cmu-argus-2/Avionics-Mainboard/Avionics-MainBoard.step

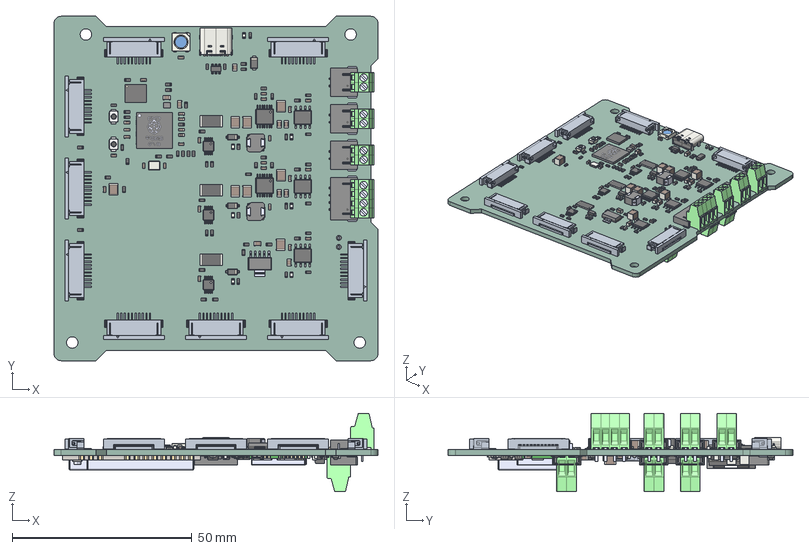
[picture p1: CAD file, 2025-10-24]
Avionics-MainBoard.step
90.2 x 95.9 x 21.8 mm
R_0603_1608Metric x 146
R_2512_6332Metric x 3
C_0603_1608Metric x 53
AOTA-B201610S3R3-101-T
C_0805_2012Metric x 15
SW_SPST_B3U-1000P x 2
MSOP-10_3x3mm_P0.5mm x 3
HSOP-8-1EP_3.9x4.9mm_P1.27mm_EP2.41x3.1mm x 3
DFN-8-1EP_6x5mm_P1.27mm_EP4x4mm
LED_0603_1608Metric x 7
C_1210_3225Metric x 12
Crystal_SMD_3225-4Pin_3.2x2.5mm
RP2350B
LED_WS2812B_PLCC4_5.0x5.0mm_P3.2mm
USB_C_Receptacle_GCT_USB4105-xx-A_16P_TopMnt_Horizontal
D_PowerDI-123
D_SOD-123 x 3
SPM5030T-3R3M-HZ x 2
Fuse_0603_1608Metric x 3
TPS7A4501DCQT
SOT-23-6
HTSSOP-14-1EP_4.4x5mm_P0.65mm_EP3.4x5mm_Mask3x3.1mm x 2
SOT-363_SC-70-6 x 22
D_SMA
SOT-23 x 3
SOIC-8_3.9x4.9mm_P1.27mm
E22-900M30S
DFN-6-1EP_2x2mm_P0.65mm_EP1x1.6mm
SOIC-16W_7.5x10.3mm_P1.27mm
BMX160_BOS
BatteryHolder_LINX_BAT-HLD-012-SMT
TSOT-23-6
SIRA99DP-T1-GE3
U.FL_Hirose_U.FL-R-SMT-1_Vertical
GPS
Avionics-MainBoard_PCB
