cmu-argus-2/Avionics-Mainboard/(threads)

Thread 10 (2025-01-13):

Fix Radio GPIO pinout

NeilKhera, 2025-01-13:
We forgot to route the interrupt pin, whoops

Closed 2025-03-11.

Thread 13 (2025-01-13):

Make RTC resettable

NeilKhera, 2025-01-13:
At the moment the RTC receives contant power from the button cell aka there is no way to power cycle it.

NeilKhera, 2025-06-04:
Likely no fix

Thread 16 (2025-01-13):

Update IC part variants

NeilKhera, 2025-01-13:
Want to be explicit about which variant we are using for certain ICs
Replace BQ25883 to BQ25886 (non I2C)
Replace DS3231S with DS3231SN (Industrial version)
Replace BNO085 with BNO086 (Lower power consumption?)

Closed 2025-03-11.

Thread 18 (2025-01-13):

Mainboard v3 Schematic Completed

NeilKhera, 2025-01-13:
Final Issue checkoff when the schematic is completed

Closed 2025-03-11.

Thread 4 (2025-01-13):

Fix USB charger coil whine

NeilKhera, 2025-01-13:

NeilKhera, 2025-01-13:
TODO: Replace inductor with one that the datasheet recommends

Closed 2025-03-11.

Thread 6 (2025-01-13):

Flaky IMU connections

NeilKhera, 2025-01-13:
Likely a result of bad solder joints. TODO: Update footprint to increase pad size (see, PyCubed-Mini)

NeilKhera, 2025-06-04:
Replace IMU to the BMX160
