cmu-argus-2/Avionics-Mainboard/Avionics-MainBoard.kicad_pcb

## KiCad design Avionics-MainBoard.kicad_pcb (2026-09-04)

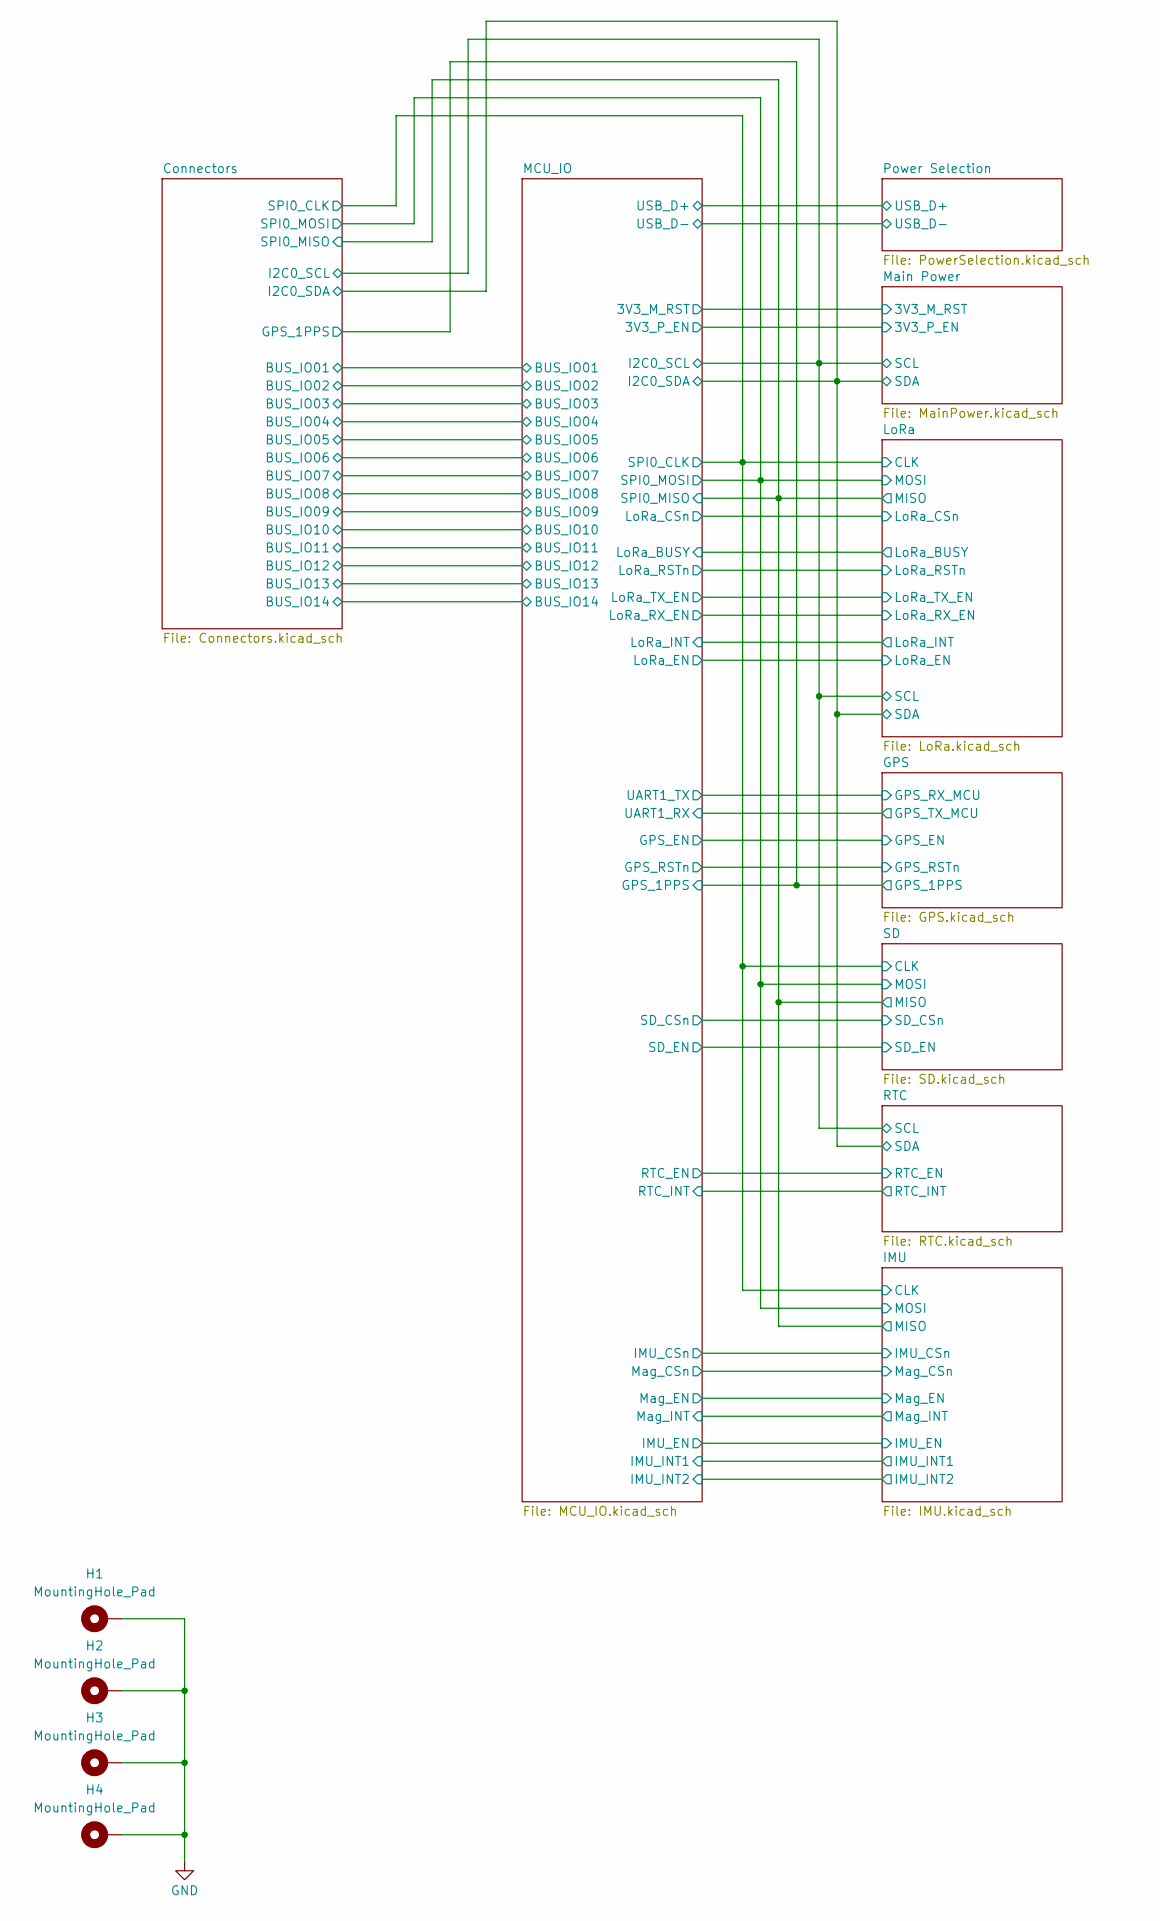
[picture p2: schematic Avionics-MainBoard.kicad_sch, Argus Mainboard]

Parts:
H1, H2, H3, H4: MountingHole_Pad; MountingHole_3.2mm_M3_Pad_Via

Connections:
GND: H1.1 (1_1), H2.1 (1_1), H3.1 (1_1), H4.1 (1_1); also elsewhere on the board

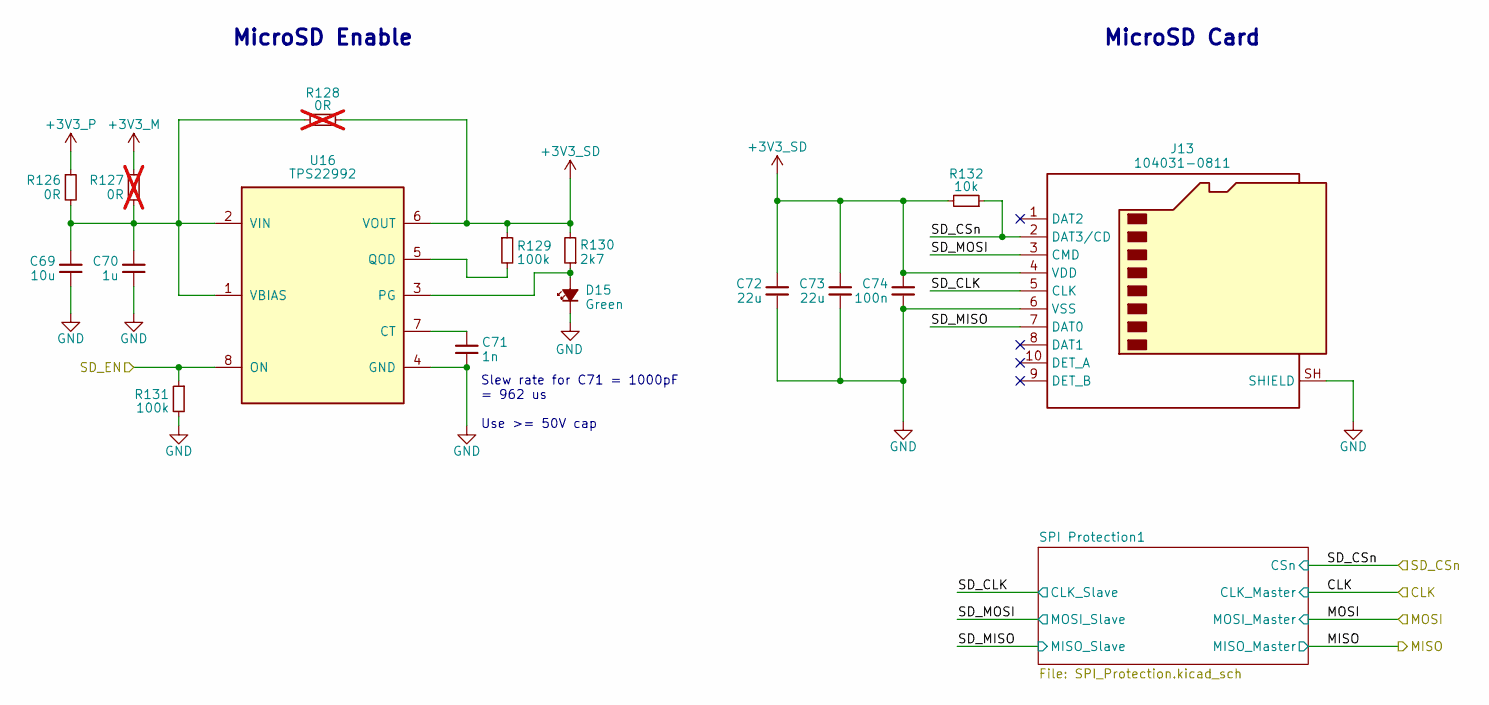
[picture p3: schematic SD.kicad_sch, Argus Mainboard]

Parts:
C69: 10u; C_0805_2012Metric; MPN C307348
C70: 1u; C_0603_1608Metric; MPN C307348
C71: 1n; C_0603_1608Metric; MPN C307348
C72, C73: 22u; C_1210_3225Metric
C74: 100n; C_0603_1608Metric; MPN C307348
D15: LED_G_0603_LTST-C190GKT; LED_0603_1608Metric; MPN C2909774
J13: 104031-0811; microSD_HC_Molex_104031-0811; MPN C585350
R126: 0R; R_0603_1608Metric
R127: 0R; R_0603_1608Metric; not fitted
R128: 0R; R_0603_1608Metric; MPN C2479067; not fitted
R129, R131: 100k; R_0603_1608Metric; MPN C2479067
R130: 2k7; R_0603_1608Metric; MPN C237112
R132: 10k; R_0603_1608Metric; MPN C2479067
U16: TPS22992

Connections:
+3V3_M: R127.1; also elsewhere on the board
+3V3_P: R126.1; also elsewhere on the board
+3V3_SD: C72.1, C73.1, C74.1, J13.4 (VDD), R128.1, R129.1, R130.2, R132.2, U16.6 (VOUT)
/MCU_IO/SD_CSn: J13.2 (DAT3/CD), R132.1; also elsewhere on the board
/MCU_IO/SD_EN: R131.1, U16.8 (ON); also elsewhere on the board
/SD/SD_CLK: J13.5 (CLK); also elsewhere on the board
/SD/SD_MISO: J13.7 (DAT0); also elsewhere on the board
/SD/SD_MOSI: J13.3 (CMD); also elsewhere on the board
GND: C69.2, C70.2, C71.2, C72.2, C73.2, C74.2, D15.1 (K), J13.6 (VSS), J13.SH (SHIELD), R131.2, U16.4 (GND); also elsewhere on the board
unnamed: D15.2 (A), R130.1, U16.3 (PG)
unnamed: C71.1, U16.7 (CT)
unnamed: R129.2, U16.5 (QOD)
unnamed: C69.1, C70.1, R126.2, R127.2, R128.2, U16.1 (VBIAS), U16.2 (VIN)

Notes on the sheet:
Slew rate for C71 = 1000pF = 962 us Use >= 50V cap
MicroSD Enable
MicroSD Card

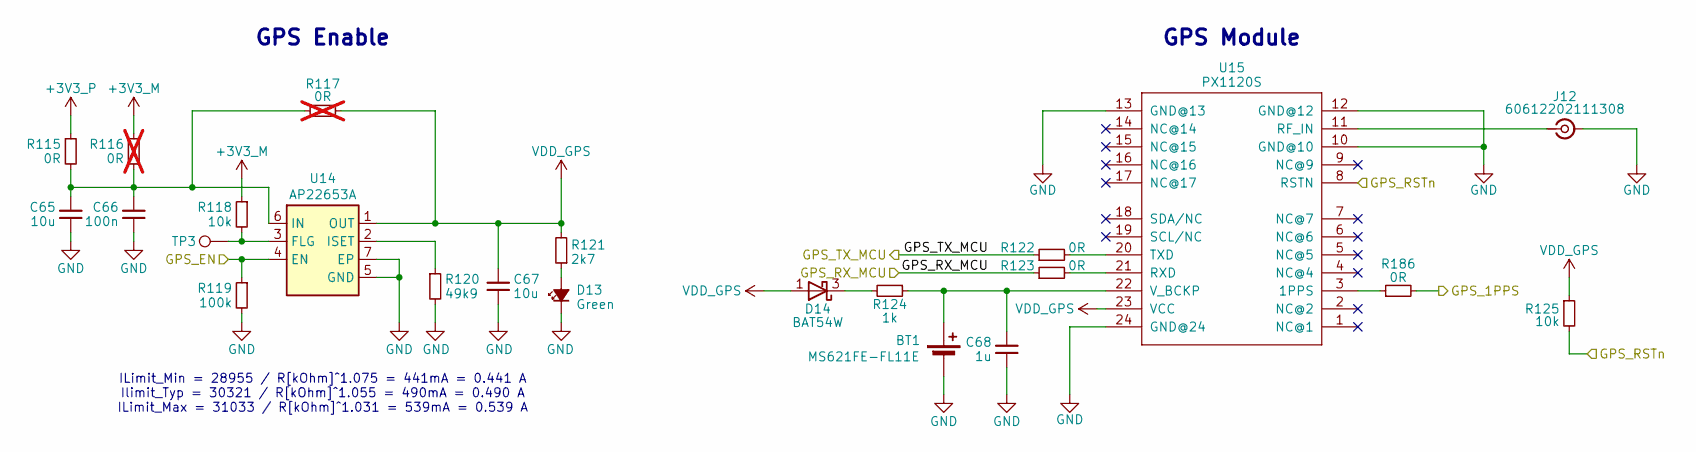
[picture p4: schematic GPS.kicad_sch, Argus Mainboard]

Parts:
BT1: MS621FE-FL11E; BatteryHolder_Seiko_MS621F; MPN MS621FE-FL11E
C65, C67: 10u; C_0805_2012Metric; MPN C386084
C66: 100n; C_0603_1608Metric; MPN C307348
C68: 1u; C_0603_1608Metric; MPN C2214844
D13: LED_G_0603_LTST-C190GKT; LED_0603_1608Metric; MPN C2909774
D14: BAT54W; SOT-323_SC-70
J12: 60612202111308; MPN C88374
R115: 0R; R_0603_1608Metric
R116: 0R; R_0603_1608Metric; not fitted
R117: 0R; R_0603_1608Metric; MPN C2479067; not fitted
R118, R125: 10k; R_0603_1608Metric; MPN C2479067
R119: 100k; R_0603_1608Metric; MPN C237792
R120: 49k9; R_0603_1608Metric; MPN C844789
R121: 2k7; R_0603_1608Metric; MPN C237112
R122, R123, R186: 0R; R_0603_1608Metric; MPN C844915
R124: 1k; R_0603_1608Metric; MPN C2076947
TP3: TestPoint; TestPoint_Pad_D1.5mm
U14: AP22653A; DFN-6-1EP_2x2mm_P0.65mm_EP1x1.6mm; MPN C1511768
U15: PX1120S; S1216_24PIN_PACKAGE

Connections:
+3V3_M: R116.1, R118.1; also elsewhere on the board
+3V3_P: R115.1; also elsewhere on the board
/GPS/GPS_RX_MCU: R123.1; also elsewhere on the board
/GPS/GPS_TX_MCU: R122.1; also elsewhere on the board
/MCU_IO/GPS_1PPS: R186.2; also elsewhere on the board
/MCU_IO/GPS_EN: R119.1, U14.4 (EN); also elsewhere on the board
/MCU_IO/GPS_RSTn: R125.2, U15.8 (RSTN); also elsewhere on the board
GND: BT1.2 (-), C65.1, C66.1, C67.1, C68.1, D13.1 (K), J12.2 (Ext), R119.2, R120.2, U14.5 (GND), U14.7 (EP), U15.10 (GND@10), U15.12 (GND@12), U15.13 (GND@13), U15.24 (GND@24); also elsewhere on the board
unnamed: BT1.1 (+), C68.2, R124.1, U15.22 (V_BCKP)
unnamed: D13.2 (A), R121.1
unnamed: D14.3 (K), R124.2
unnamed: J12.1 (In), U15.11 (RF_IN)
unnamed: R118.2, TP3.1 (1_1), U14.3 (FLG)
unnamed: C65.2, C66.2, R115.2, R116.2, R117.2, U14.6 (IN)
unnamed: R120.1, U14.2 (ISET)
unnamed: R186.1, U15.3 (1PPS)
unnamed: R123.2, U15.21 (RXD)
unnamed: R122.2, U15.20 (TXD)
VDD_GPS: C67.2, D14.1 (A), R117.1, R121.2, R125.1, U14.1 (OUT), U15.23 (VCC)

Notes on the sheet:
ILimit_Min = 28955 / R[kOhm]^1.075 = 441mA = 0.441 A Ilimit_Typ = 30321 / R[kOhm]^1.055 = 490mA = 0.490 A ILimit_Max = 31033 / R[kOhm]^1.031 = 539mA = 0.539 A
GPS Enable
GPS Module

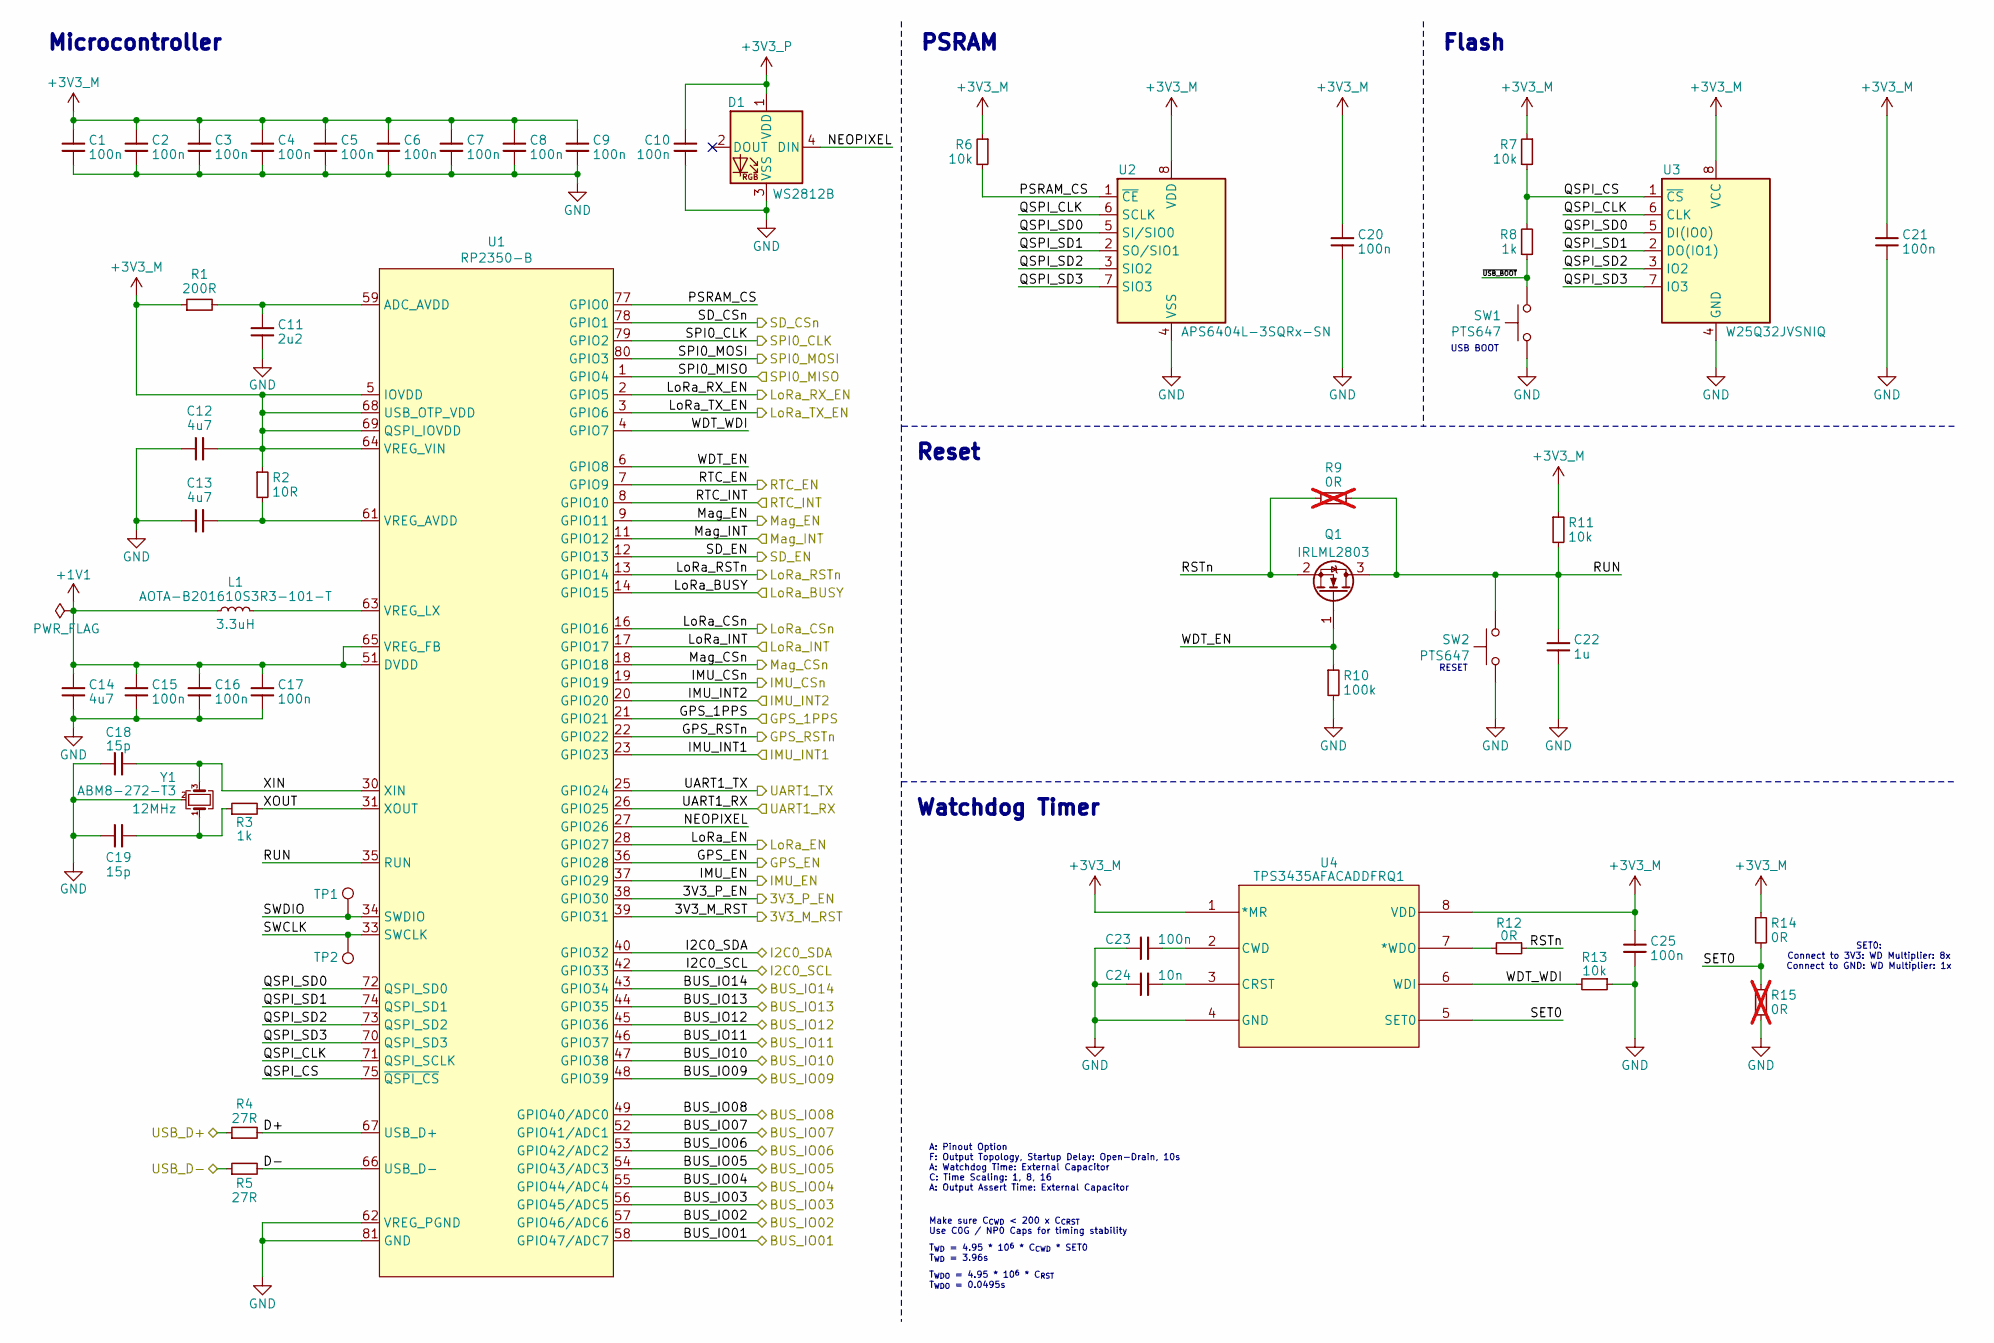
[picture p5: schematic MCU_IO.kicad_sch, Argus Mainboard]

Parts:
C1, C2, C3, C4, C5, C6, C7, C8, C9, C10, C15, C16, C17, C20, C21, C25: 100n; C_0603_1608Metric; MPN C307348
C11: 2u2; C_0603_1608Metric; MPN C16193991
C12, C13: 4u7; C_0805_2012Metric; MPN C3861036
C14: 4u7; C_0805_2012Metric; MPN C386084
C18, C19: 15p; C_0603_1608Metric; MPN C346205
C22: 1u; C_0603_1608Metric; MPN C2214844
C23: 100n; C_1210_3225Metric; MPN C307348
C24: 10n; C_0603_1608Metric; MPN C307348
D1: WS2812B; LED_WS2812B_PLCC4_5.0x5.0mm_P3.2mm; MPN C2890040
L1: AOTA-B201610S3R3-101-T; L_0806_2016Metric; MPN C42411119
Q1: IRLML2803; SOT-23; MPN C2590
R1: 200R; R_0603_1608Metric; MPN C844757
R2: 10R; R_0603_1608Metric; MPN C3029194
R3, R8: 1k; R_0603_1608Metric; MPN C2484712
R4, R5: 27R; R_0603_1608Metric; MPN C844545
R6, R7, R11, R13: 10k; R_0603_1608Metric; MPN C2479067
R9: 0R; R_0603_1608Metric; not fitted
R10: 100k; R_0603_1608Metric; MPN C237792
R12: 0R; R_0603_1608Metric; MPN C2479067
R14: 0R; R_0603_1608Metric; MPN C3029194
R15: 0R; R_0603_1608Metric; MPN C3029194; not fitted
SW1, SW2: PTS647; SW_SPST_PTS647_Sx38; MPN C231329
TP1, TP2: TestPoint; TestPoint_Pad_D1.5mm
U1: RP2350-B; RP2350-QFN-80-1EP_10x10_P0.4mm_EP3.4x3.4mm_ThermalVias; MPN C42415655
U2: APS6404L-3SQRx-SN; SOIC-8_3.9x4.9mm_P1.27mm
U3: W25Q32JVSNIQ; DFN-8-1EP_6x5mm_P1.27mm_EP2x2mm
U4: TPS3435AFACADDFRQ1; TSOT-23-8
Y1: ABM8-272-T3; Crystal_SMD_3225-4Pin_3.2x2.5mm; Part 12MHz

Connections:
+1V1: C14.1, C15.1, C16.1, C17.1, L1.1, U1.10 (DVDD), U1.32 (DVDD), U1.51 (DVDD), U1.65 (VREG_FB)
+3V3_M: C1.1, C2.1, C3.1, C4.1, C5.1, C6.1, C7.1, C8.1, C9.1, C12.2, C20.1, C21.1, C25.1, R1.1, R2.1, R6.1, R7.1, R11.1, R14.1, U1.5 (IOVDD), U1.15 (IOVDD), U1.24 (IOVDD), U1.29 (IOVDD), U1.41 (IOVDD), U1.50 (IOVDD), U1.60 (IOVDD), U1.64 (VREG_VIN), U1.68 (USB_OTP_VDD), U1.69 (QSPI_IOVDD), U1.76 (IOVDD), U2.8 (VDD), U3.8 (VCC), U4.1 (*MR), U4.8 (VDD); also elsewhere on the board
+3V3_P: C10.1, D1.1 (VDD); also elsewhere on the board
/GPS/GPS_RX_MCU: U1.25 (GPIO24); also elsewhere on the board
/GPS/GPS_TX_MCU: U1.26 (GPIO25); also elsewhere on the board
/IMU/CLK: U1.79 (GPIO2); also elsewhere on the board
/IMU/IMU_CSn: U1.19 (GPIO19); also elsewhere on the board
/IMU/IMU_INT1: U1.23 (GPIO23); also elsewhere on the board
/IMU/IMU_INT2: U1.20 (GPIO20); also elsewhere on the board
/IMU/MISO: U1.1 (GPIO4); also elsewhere on the board
/IMU/MOSI: U1.80 (GPIO3); also elsewhere on the board
/IMU/Mag_CSn: U1.18 (GPIO18); also elsewhere on the board
/IMU/Mag_INT: U1.11 (GPIO12); also elsewhere on the board
/LoRa/LoRa_BUSY: U1.14 (GPIO15); also elsewhere on the board
/LoRa/LoRa_CSn: U1.16 (GPIO16); also elsewhere on the board
/LoRa/LoRa_INT: U1.17 (GPIO17); also elsewhere on the board
/LoRa/LoRa_RSTn: U1.13 (GPIO14); also elsewhere on the board
/LoRa/LoRa_RX_EN: U1.2 (GPIO5); also elsewhere on the board
/LoRa/LoRa_TX_EN: U1.3 (GPIO6); also elsewhere on the board
/MCU_IO/3V3_M_RST: U1.39 (GPIO31); also elsewhere on the board
/MCU_IO/3V3_P_EN: U1.38 (GPIO30); also elsewhere on the board
/MCU_IO/BUS_IO01: U1.58 (GPIO47/ADC7); also elsewhere on the board
/MCU_IO/BUS_IO02: U1.57 (GPIO46/ADC6); also elsewhere on the board
/MCU_IO/BUS_IO03: U1.56 (GPIO45/ADC5); also elsewhere on the board
/MCU_IO/BUS_IO04: U1.55 (GPIO44/ADC4); also elsewhere on the board
/MCU_IO/BUS_IO05: U1.54 (GPIO43/ADC3); also elsewhere on the board
/MCU_IO/BUS_IO06: U1.53 (GPIO42/ADC2); also elsewhere on the board
/MCU_IO/BUS_IO07: U1.52 (GPIO41/ADC1); also elsewhere on the board
/MCU_IO/BUS_IO08: U1.49 (GPIO40/ADC0); also elsewhere on the board
/MCU_IO/BUS_IO09: U1.48 (GPIO39); also elsewhere on the board
/MCU_IO/BUS_IO10: U1.47 (GPIO38); also elsewhere on the board
/MCU_IO/BUS_IO11: U1.46 (GPIO37); also elsewhere on the board
/MCU_IO/BUS_IO12: U1.45 (GPIO36); also elsewhere on the board
/MCU_IO/BUS_IO13: U1.44 (GPIO35); also elsewhere on the board
/MCU_IO/BUS_IO14: U1.43 (GPIO34); also elsewhere on the board
/MCU_IO/D+: R4.2, U1.67 (USB_D+)
/MCU_IO/D-: R5.2, U1.66 (USB_D-)
/MCU_IO/GPS_1PPS: U1.21 (GPIO21); also elsewhere on the board
/MCU_IO/GPS_EN: U1.36 (GPIO28); also elsewhere on the board
/MCU_IO/GPS_RSTn: U1.22 (GPIO22); also elsewhere on the board
/MCU_IO/I2C0_SCL: U1.42 (GPIO33); also elsewhere on the board
/MCU_IO/I2C0_SDA: U1.40 (GPIO32); also elsewhere on the board
/MCU_IO/IMU_EN: U1.37 (GPIO29); also elsewhere on the board
/MCU_IO/LoRa_EN: U1.28 (GPIO27); also elsewhere on the board
/MCU_IO/Mag_EN: U1.9 (GPIO11); also elsewhere on the board
/MCU_IO/NEOPIXEL: D1.4 (DIN), U1.27 (GPIO26)
/MCU_IO/PSRAM_CS: R6.2, U1.77 (GPIO0), U2.1 (~CE)
/MCU_IO/QSPI_CLK: U1.71 (QSPI_SCLK), U2.6 (SCLK), U3.6 (CLK)
/MCU_IO/QSPI_CS: R7.2, R8.2, U1.75 (~QSPI_CS), U3.1 (~CS)
/MCU_IO/QSPI_SD0: U1.72 (QSPI_SD0), U2.5 (SI/SIO0), U3.5 (DI(IO0))
/MCU_IO/QSPI_SD1: U1.74 (QSPI_SD1), U2.2 (SO/SIO1), U3.2 (DO(IO1))
/MCU_IO/QSPI_SD2: U1.73 (QSPI_SD2), U2.3 (SIO2), U3.3 (IO2)
/MCU_IO/QSPI_SD3: U1.70 (QSPI_SD3), U2.7 (SIO3), U3.7 (IO3)
/MCU_IO/RSTn: Q1.2 (S), R9.1, R12.1
/MCU_IO/RTC_EN: U1.7 (GPIO9); also elsewhere on the board
/MCU_IO/RTC_INT: U1.8 (GPIO10); also elsewhere on the board
/MCU_IO/RUN: C22.1, Q1.3 (D), R9.2, R11.2, SW2.2, U1.35 (RUN)
/MCU_IO/SD_CSn: U1.78 (GPIO1); also elsewhere on the board
/MCU_IO/SD_EN: U1.12 (GPIO13); also elsewhere on the board
/MCU_IO/SET0: R14.2, R15.1, U4.5 (SET0)
/MCU_IO/SWCLK: TP2.1 (1_1), U1.33 (SWCLK)
/MCU_IO/SWDIO: TP1.1 (1_1), U1.34 (SWDIO)
/MCU_IO/WDT_EN: Q1.1 (G), R10.1, U1.6 (GPIO8)
/MCU_IO/WDT_WDI: R13.2, U1.4 (GPIO7), U4.6 (WDI)
/MCU_IO/XIN: C18.2, U1.30 (XIN), Y1.3
/MCU_IO/XOUT: R3.2, U1.31 (XOUT)
/MCU_IO/~USB_BOOT: R8.1, SW1.2
/Power Selection/USB_D+: R4.1; also elsewhere on the board
/Power Selection/USB_D-: R5.1; also elsewhere on the board
GND: C1.2, C2.2, C3.2, C4.2, C5.2, C6.2, C7.2, C8.2, C9.2, C10.2, C11.1, C12.1, C13.2, C14.2, C15.2, C16.2, C17.2, C18.1, C19.2, C20.2, C21.2, C22.2, C23.2, C24.2, C25.2, D1.3 (VSS), R10.2, R13.1, R15.2, SW1.1, SW2.1, U1.62 (VREG_PGND), U1.81 (GND), U2.4 (VSS), U3.4 (GND), U3.9 (GND), U4.4 (GND), Y1.2 (G), Y1.4 (G); also elsewhere on the board
unnamed: C19.1, R3.1, Y1.1
unnamed: C11.2, R1.2, U1.59 (ADC_AVDD)
unnamed: C13.1, R2.2, U1.61 (VREG_AVDD)
unnamed: L1.2, U1.63 (VREG_LX)
unnamed: R12.2, U4.7 (*WDO)
unnamed: C24.1, U4.3 (CRST)
unnamed: C23.1, U4.2 (CWD)

Notes on the sheet:
USB BOOT
Reset
RESET
SET0: Connect to 3V3: WD Multiplier: 8x Connect to GND: WD Multiplier: 1x
T_{WDO} = 4.95 * 10^{6} * C_{RST} T_{WDO} = 0.0495s
Make sure C_{CWD} < 200 x C_{CRST} Use C0G / NP0 Caps for timing stability
T_{WD} = 4.95 * 10^{6} * C_{CWD} * SET0 T_{WD} = 3.96s
Watchdog Timer
PSRAM
Flash
A: Pinout Option F: Output Topology, Startup Delay: Open-Drain, 10s A: Watchdog Time: External Capacitor C: Time Scaling: 1, 8, 16 A: Output Assert Time: External Capacitor
Microcontroller

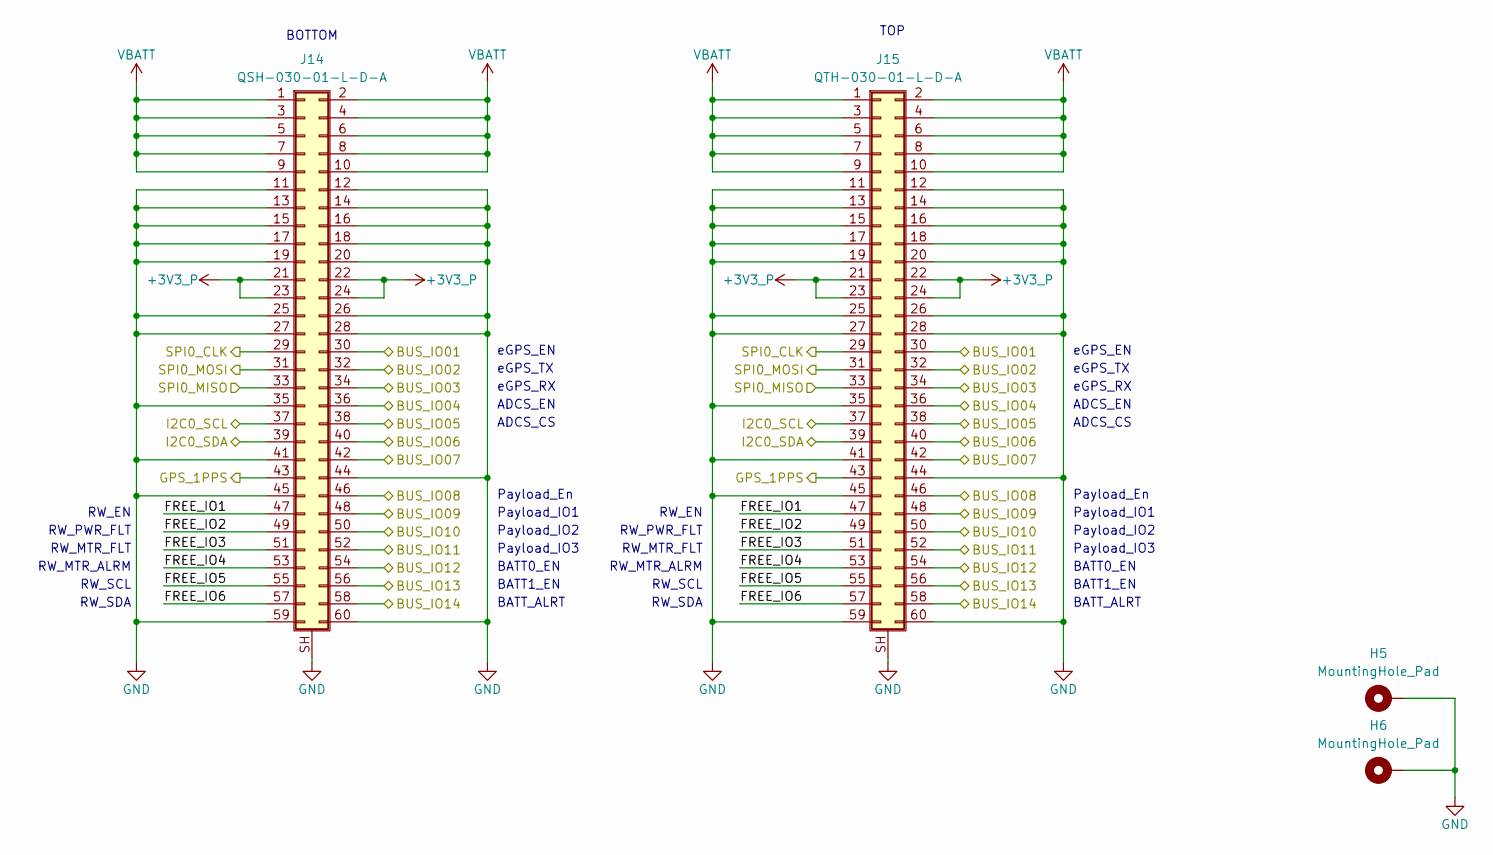
[picture p6: schematic Connectors.kicad_sch, Argus Mainboard]

Parts:
H5, H6: MountingHole_Pad; MountingHole_2.7mm_M2.5_Pad_Via
J14: QSH-030-01-L-D-A; SAMTEC_QSH-030-01-L-D-A
J15: QTH-030-01-L-D-A; SAMTEC-QTH-030-01-X-D-A

Connections:
+3V3_P: J14.21, J14.22, J14.23, J14.24, J15.21, J15.22, J15.23, J15.24; also elsewhere on the board
/Connectors/FREE_IO1: J14.47, J15.47
/Connectors/FREE_IO2: J14.49, J15.49
/Connectors/FREE_IO3: J14.51, J15.51
/Connectors/FREE_IO4: J14.53, J15.53
/Connectors/FREE_IO5: J14.55, J15.55
/Connectors/FREE_IO6: J14.57, J15.57
/IMU/CLK: J14.29, J15.29; also elsewhere on the board
/IMU/MISO: J14.33, J15.33; also elsewhere on the board
/IMU/MOSI: J14.31, J15.31; also elsewhere on the board
/MCU_IO/BUS_IO01: J14.30, J15.30; also elsewhere on the board
/MCU_IO/BUS_IO02: J14.32, J15.32; also elsewhere on the board
/MCU_IO/BUS_IO03: J14.34, J15.34; also elsewhere on the board
/MCU_IO/BUS_IO04: J14.36, J15.36; also elsewhere on the board
/MCU_IO/BUS_IO05: J14.38, J15.38; also elsewhere on the board
/MCU_IO/BUS_IO06: J14.40, J15.40; also elsewhere on the board
/MCU_IO/BUS_IO07: J14.42, J15.42; also elsewhere on the board
/MCU_IO/BUS_IO08: J14.46, J15.46; also elsewhere on the board
/MCU_IO/BUS_IO09: J14.48, J15.48; also elsewhere on the board
/MCU_IO/BUS_IO10: J14.50, J15.50; also elsewhere on the board
/MCU_IO/BUS_IO11: J14.52, J15.52; also elsewhere on the board
/MCU_IO/BUS_IO12: J14.54, J15.54; also elsewhere on the board
/MCU_IO/BUS_IO13: J14.56, J15.56; also elsewhere on the board
/MCU_IO/BUS_IO14: J14.58, J15.58; also elsewhere on the board
/MCU_IO/GPS_1PPS: J14.43, J15.43; also elsewhere on the board
/MCU_IO/I2C0_SCL: J14.37, J15.37; also elsewhere on the board
/MCU_IO/I2C0_SDA: J14.39, J15.39; also elsewhere on the board
GND: H5.1 (1_1), H6.1 (1_1), J14.11, J14.12, J14.13, J14.14, J14.15, J14.16, J14.17, J14.18, J14.19, J14.20, J14.25, J14.26, J14.27, J14.28, J14.35, J14.41, J14.44, J14.45, J14.59, J14.60, J14.SH (Shield), J15.11, J15.12, J15.13, J15.14, J15.15, J15.16, J15.17, J15.18, J15.19, J15.20, J15.25, J15.26, J15.27, J15.28, J15.35, J15.41, J15.44, J15.45, J15.59, J15.60, J15.SH (Shield); also elsewhere on the board
VBATT: J14.1, J14.2, J14.3, J14.4, J14.5, J14.6, J14.7, J14.8, J14.9, J14.10, J15.1, J15.2, J15.3, J15.4, J15.5, J15.6, J15.7, J15.8, J15.9, J15.10; also elsewhere on the board

Notes on the sheet:
BATT1_EN
RW_SCL
RW_PWR_FLT
Payload_IO1
Payload_En
RW_EN
eGPS_TX
eGPS_EN
eGPS_RX
BATT_ALRT
RW_MTR_FLT
ADCS_CS
RW_MTR_ALRM
Payload_IO3
BOTTOM
BATT0_EN
RW_SDA
ADCS_EN
Payload_IO2
TOP

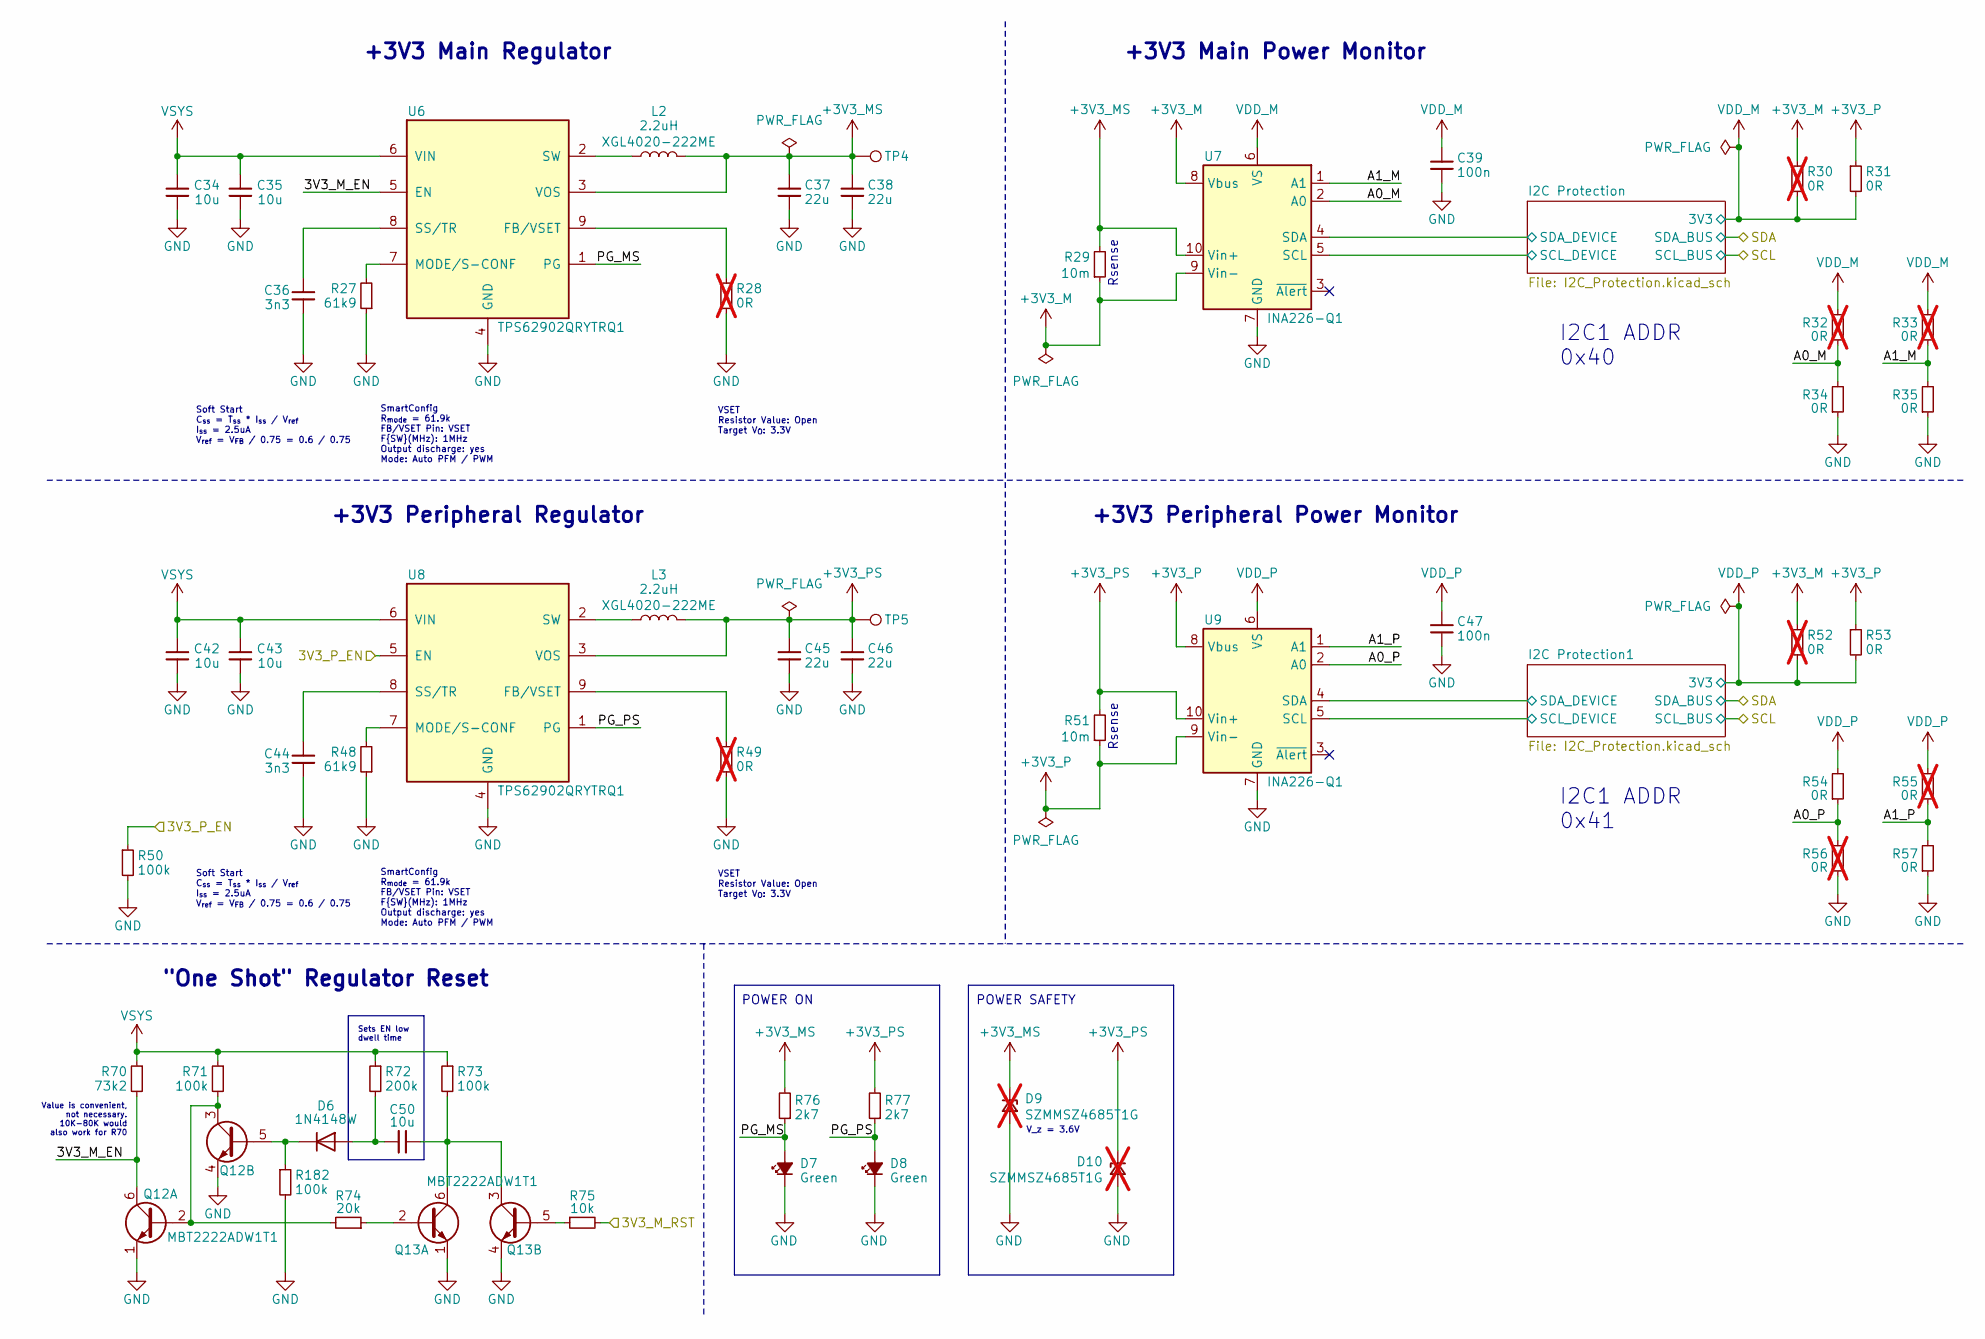
[picture p7: schematic MainPower.kicad_sch, Argus Mainboard]

Parts:
C34, C35, C42, C43, C50: 10u; C_0805_2012Metric; MPN C386084
C36, C44: 3n3; C_0603_1608Metric; MPN C3877267
C37, C38, C45, C46: 22u; C_1210_3225Metric; MPN C2803395
C39, C47: 100n; C_0603_1608Metric; MPN C2803395
D6: 1N4148W; D_SOD-123
D7, D8: LED_G_0603_LTST-C190GKT; LED_0603_1608Metric; MPN C2909774
D9, D10: SZMMSZ4685T1G; D_SOD-123; not fitted
L2, L3: 2.2uH; L_Coilcraft_XAL4020-XXX
Q12: MBT2222ADW1T1; SOT-363_SC-70-6
Q13: MBT2222ADW1T1; SOT-363_SC-70-6; Manufacturer_Part_Number MBT2222ADW1T1G
R27, R48: 61k9; R_0603_1608Metric; MPN C844759
R28, R49: 0R; R_0603_1608Metric; MPN C844759; not fitted
R29, R51: 10m; R_1206_3216Metric; MPN C840621
R30, R52: 0R; R_0603_1608Metric; MPN C237792; not fitted
R31, R53: 0R; R_0603_1608Metric; MPN C237792
R32, R33, R55, R56: 0R; R_0603_1608Metric; MPN C844915; not fitted
R34, R35, R54, R57: 0R; R_0603_1608Metric; MPN C844915
R50, R71, R73, R182: 100k; R_0603_1608Metric; MPN C237792
R70: 73k2; R_0603_1608Metric; MPN C843966
R72: 200k; R_0603_1608Metric; MPN C118142
R74: 20k; R_0603_1608Metric; MPN C844923
R75: 10k; R_0603_1608Metric; MPN C2479067
R76, R77: 2k7; R_0603_1608Metric; MPN C237112
TP4, TP5: TestPoint; TestPoint_Pad_D1.5mm
U6, U8: TPS62902QRYTRQ1
U7, U9: INA226-Q1; TSSOP-10_3x3mm_P0.5mm

Connections:
+3V3_M: R29.1, R30.1, R52.1, U7.8 (Vbus), U7.9 (Vin-); also elsewhere on the board
+3V3_MS: C37.2, C38.2, D9.1 (K), L2.2, R29.2, R76.2, TP4.1 (1_1), U6.3 (VOS), U7.10 (Vin+)
+3V3_P: R31.1, R51.1, R53.1, U9.8 (Vbus), U9.9 (Vin-); also elsewhere on the board
+3V3_PS: C45.2, C46.2, D10.1 (K), L3.2, R51.2, R77.2, TP5.1 (1_1), U8.3 (VOS), U9.10 (Vin+)
/MCU_IO/3V3_M_RST: R75.2; also elsewhere on the board
/MCU_IO/3V3_P_EN: R50.1, U8.5 (EN); also elsewhere on the board
/Main Power/3V3_M_EN: Q12.6 (C1), R70.2, U6.5 (EN)
/Main Power/A0_M: R32.1, R34.2, U7.2 (A0)
/Main Power/A0_P: R54.1, R56.2, U9.2 (A0)
/Main Power/A1_M: R33.1, R35.2, U7.1 (A1)
/Main Power/A1_P: R55.1, R57.2, U9.1 (A1)
/Main Power/I2C Protection1/SCL_DEVICE: U9.5 (SCL); also elsewhere on the board
/Main Power/I2C Protection1/SDA_DEVICE: U9.4 (SDA); also elsewhere on the board
/Main Power/I2C Protection/SCL_DEVICE: U7.5 (SCL); also elsewhere on the board
/Main Power/I2C Protection/SDA_DEVICE: U7.4 (SDA); also elsewhere on the board
/Main Power/PG_MS: D7.2 (A), R76.1, U6.1 (PG)
/Main Power/PG_PS: D8.2 (A), R77.1, U8.1 (PG)
GND: C34.2, C35.2, C36.1, C37.1, C38.1, C39.1, C42.2, C43.2, C44.1, C45.1, C46.1, C47.1, D7.1 (K), D8.1 (K), D9.2 (A), D10.2 (A), Q12.1 (E1), Q12.4 (E2), Q13.1 (E1), Q13.4 (E2), R27.1, R28.1, R34.1, R35.1, R48.1, R49.1, R50.2, R56.1, R57.1, R182.2, U6.4 (GND), U7.7 (GND), U8.4 (GND), U9.7 (GND); also elsewhere on the board
unnamed: C50.2, D6.2 (A), R72.2
unnamed: D6.1 (K), Q12.5 (B2), R182.1
unnamed: Q12.2 (B1), Q12.3 (C2), R71.2, R74.2
unnamed: Q13.2 (B1), R74.1
unnamed: C50.1, Q13.3 (C2), Q13.6 (C1), R73.2
unnamed: Q13.5 (B2), R75.1
unnamed: R28.2, U6.9 (FB/VSET)
unnamed: R27.2, U6.7 (MODE/S-CONF)
unnamed: C36.2, U6.8 (SS/TR)
unnamed: L2.1, U6.2 (SW)
unnamed: R49.2, U8.9 (FB/VSET)
unnamed: R48.2, U8.7 (MODE/S-CONF)
unnamed: C44.2, U8.8 (SS/TR)
unnamed: L3.1, U8.2 (SW)
VDD_M: C39.2, R30.2, R31.2, R32.2, R33.2, U7.6 (VS); also elsewhere on the board
VDD_P: C47.2, R52.2, R53.2, R54.2, R55.2, U9.6 (VS); also elsewhere on the board
VSYS: C34.1, C35.1, C42.1, C43.1, R70.1, R71.1, R72.1, R73.1, U6.6 (VIN), U8.6 (VIN); also elsewhere on the board

Notes on the sheet:
Rsense
VSET Resistor Value: Open Target V_{O}: 3.3V
Sets EN low dwell time
V_z = 3.6V
I2C1 ADDR 0x41
SmartConfig R_{mode} = 61.9k FB/VSET Pin: VSET F{SW}(MHz): 1MHz Output discharge: yes Mode: Auto PFM / PWM
Value is convenient, not necessary. 10K-80K would also work for R70
Soft Start C_{ss} = T_{ss} * I_{ss} / V_{ref} I_{ss} = 2.5uA V_{ref} = V_{FB} / 0.75 = 0.6 / 0.75
+3V3 Main Regulator
"One Shot" Regulator Reset
+3V3 Peripheral Power Monitor
I2C1 ADDR 0x40
+3V3 Peripheral Regulator
POWER SAFETY
+3V3 Main Power Monitor
POWER ON
