cmu-argus-2/Avionics-Mainboard/Avionics-MainBoard.kicad_pcb

## KiCad design Avionics-MainBoard.kicad_pcb (continued)

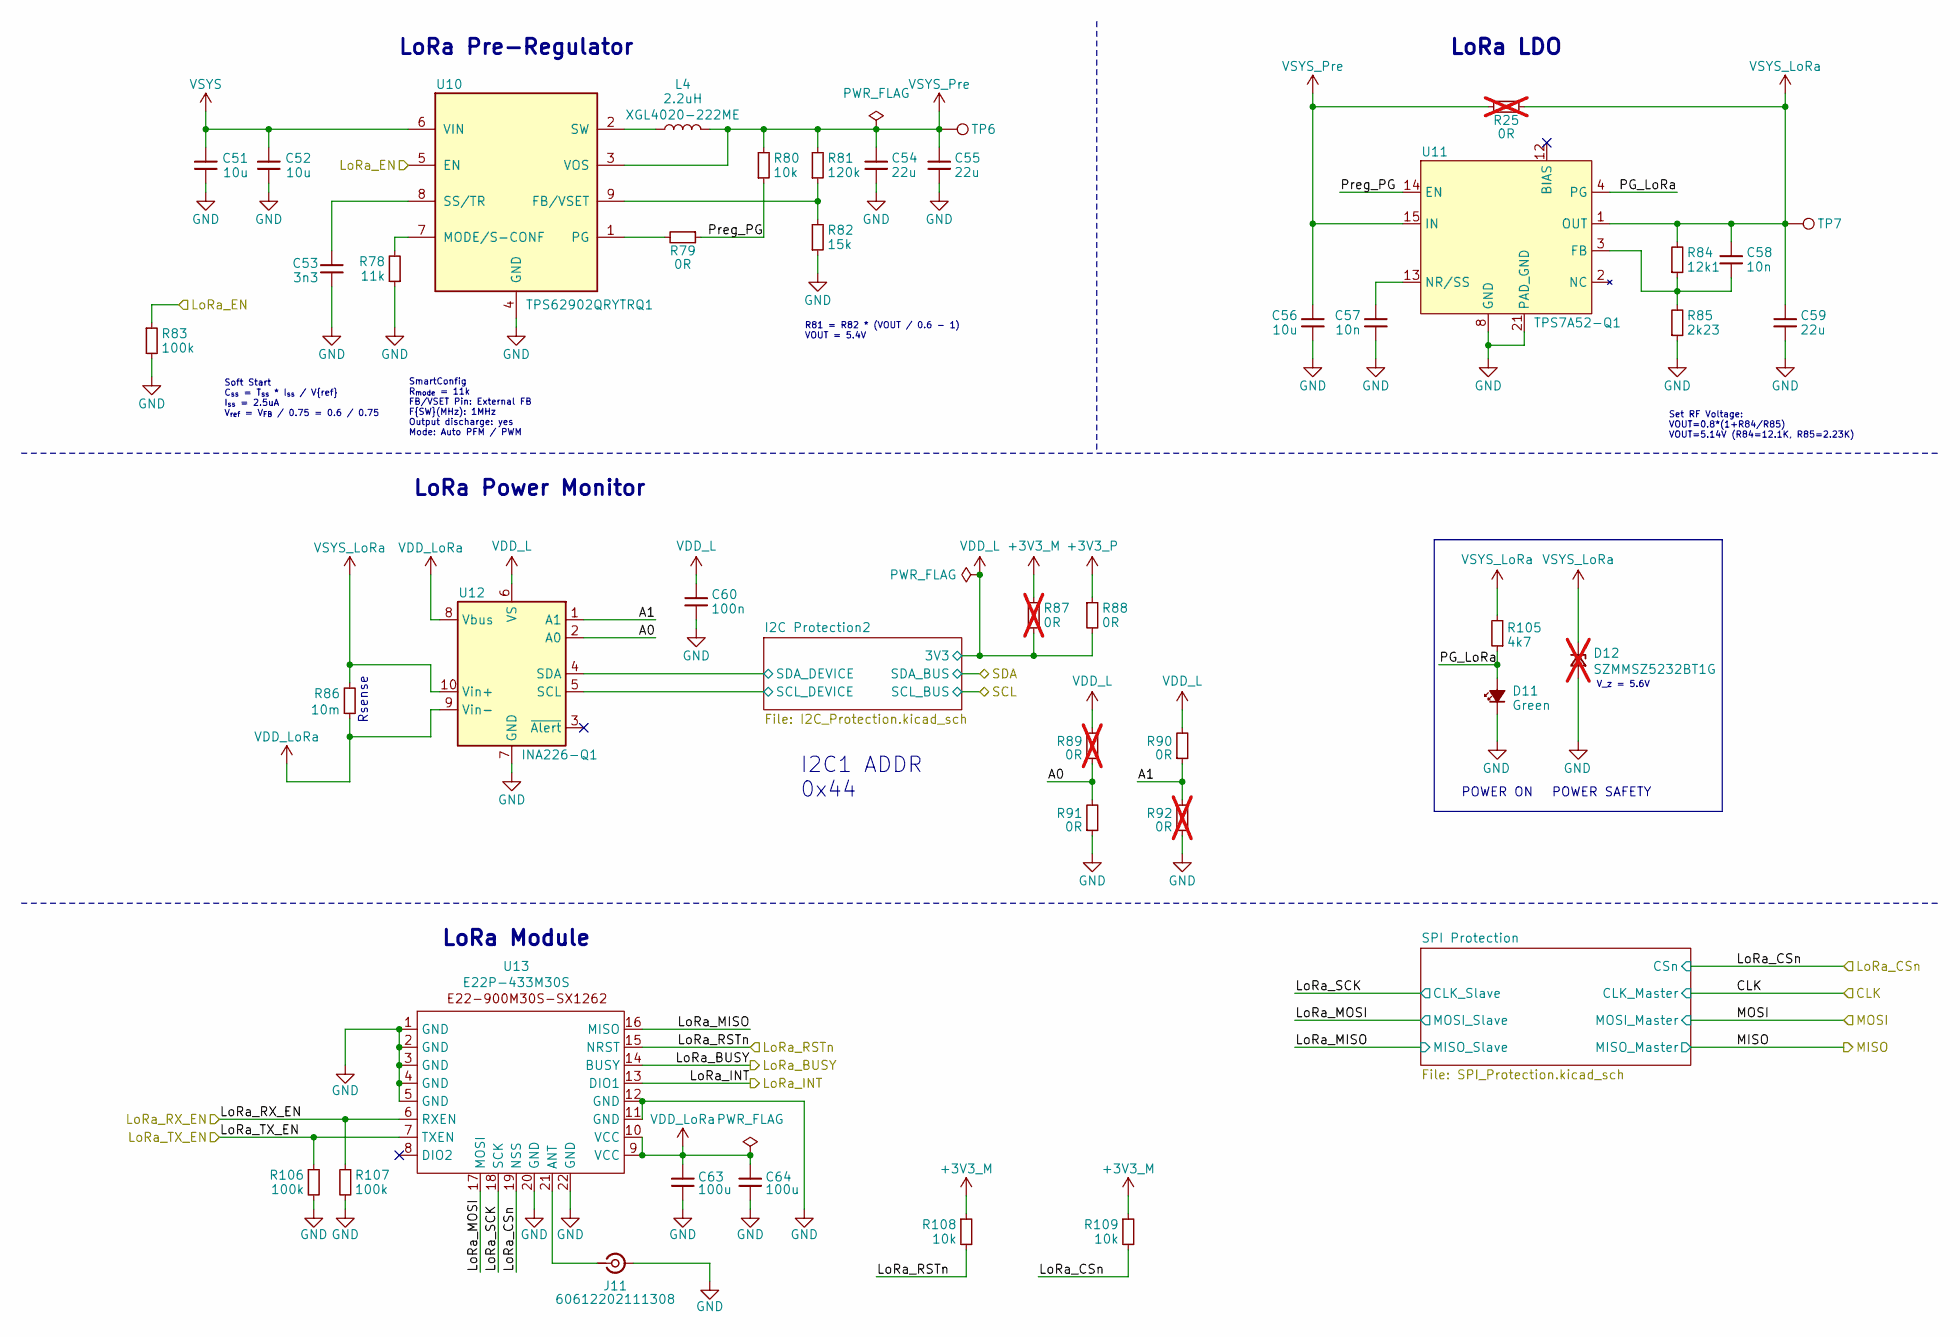
[picture p8: schematic LoRa.kicad_sch, Argus Mainboard]

Parts:
C51, C52: 10u; C_0805_2012Metric; MPN C386084
C53: 3n3; C_0603_1608Metric; MPN C3877267
C54, C55, C59: 22u; C_1210_3225Metric; MPN C2803395
C56: 10u; C_0805_2012Metric; MPN C2803395
C57, C58: 10n; C_0603_1608Metric; MPN C2803395
C60: 100n; C_0603_1608Metric; MPN C2803395
C63: 100u; C_1210_3225Metric; MPN C2214844
C64: 100u; C_1210_3225Metric; MPN C386084
D11: LED_G_0603_LTST-C190GKT; LED_0603_1608Metric; MPN C2909774
D12: SZMMSZ5232BT1G; D_SOD-123; not fitted
J11: 60612202111308; MPN C88374
L4: 2.2uH; L_Coilcraft_XAL4020-XXX
R25: 0R; R_0603_1608Metric; MPN C844759; not fitted
R78: 11k; R_0603_1608Metric; MPN C844759
R79: 0R; R_0603_1608Metric; MPN C844759
R80: 10k; R_0603_1608Metric; MPN C844759
R81: 120k; R_0603_1608Metric; MPN C844759
R82: 15k; R_0603_1608Metric; MPN C844759
R83: 100k; R_0603_1608Metric; MPN C237792
R84: 12k1; R_0603_1608Metric; MPN C844759
R85: 2k23; R_0603_1608Metric; MPN C844759
R86: 10m; R_1206_3216Metric; MPN C840621
R87: 0R; R_0603_1608Metric; MPN C237792; not fitted
R88: 0R; R_0603_1608Metric; MPN C237792
R89, R92: 0R; R_0603_1608Metric; MPN C844915; not fitted
R90, R91: 0R; R_0603_1608Metric; MPN C844915
R105: 4k7; R_0603_1608Metric; MPN C844931
R106, R107: 100k; R_0603_1608Metric; MPN C2479067
R108, R109: 10k; R_0603_1608Metric; MPN C2479067
TP6, TP7: TestPoint; TestPoint_Pad_D1.5mm
U10: TPS62902QRYTRQ1
U11: TPS7A52-Q1; TPS7A5201Q
U12: INA226-Q1; TSSOP-10_3x3mm_P0.5mm
U13: E22P-433M30S; E22-900M30S-SX1262

Connections:
+3V3_M: R87.1, R108.1, R109.1; also elsewhere on the board
+3V3_P: R88.1; also elsewhere on the board
/LoRa/A0: R89.1, R91.2, U12.2 (A0)
/LoRa/A1: R90.1, R92.2, U12.1 (A1)
/LoRa/I2C Protection2/SCL_DEVICE: U12.5 (SCL); also elsewhere on the board
/LoRa/I2C Protection2/SDA_DEVICE: U12.4 (SDA); also elsewhere on the board
/LoRa/LoRa_BUSY: U13.14 (BUSY); also elsewhere on the board
/LoRa/LoRa_CSn: R109.2, U13.19 (NSS); also elsewhere on the board
/LoRa/LoRa_INT: U13.13 (DIO1); also elsewhere on the board
/LoRa/LoRa_MISO: U13.16 (MISO); also elsewhere on the board
/LoRa/LoRa_MOSI: U13.17 (MOSI); also elsewhere on the board
/LoRa/LoRa_RSTn: R108.2, U13.15 (NRST); also elsewhere on the board
/LoRa/LoRa_RX_EN: R107.1, U13.6 (RXEN); also elsewhere on the board
/LoRa/LoRa_SCK: U13.18 (SCK); also elsewhere on the board
/LoRa/LoRa_TX_EN: R106.1, U13.7 (TXEN); also elsewhere on the board
/LoRa/PG_LoRa: D11.2 (A), R105.1, U11.4 (PG)
/LoRa/Preg_PG: R79.1, R80.1, U11.14 (EN)
/MCU_IO/LoRa_EN: R83.1, U10.5 (EN); also elsewhere on the board
GND: C51.2, C52.2, C53.1, C54.1, C55.1, C56.1, C57.1, C59.1, C60.1, C63.1, C64.1, D11.1 (K), D12.2 (A), J11.2 (Ext), R78.1, R82.1, R83.2, R85.1, R91.1, R92.1, R106.2, R107.2, U10.4 (GND), U11.8 (GND), U11.18 (GND), U11.21 (PAD_GND), U12.7 (GND), U13.1 (GND), U13.2 (GND), U13.3 (GND), U13.4 (GND), U13.5 (GND), U13.11 (GND), U13.12 (GND), U13.20 (GND), U13.22 (GND); also elsewhere on the board
unnamed: J11.1 (In), U13.21 (ANT)
unnamed: R81.1, R82.2, U10.9 (FB/VSET)
unnamed: R78.2, U10.7 (MODE/S-CONF)
unnamed: R79.2, U10.1 (PG)
unnamed: C53.2, U10.8 (SS/TR)
unnamed: L4.1, U10.2 (SW)
unnamed: C58.1, R84.1, R85.2, U11.3 (FB)
unnamed: C57.2, U11.13 (NR/SS)
VDD_L: C60.2, R87.2, R88.2, R89.2, R90.2, U12.6 (VS); also elsewhere on the board
VDD_LoRa: C63.2, C64.2, R86.1, U12.8 (Vbus), U12.9 (Vin-), U13.9 (VCC), U13.10 (VCC)
VSYS: C51.1, C52.1, U10.6 (VIN); also elsewhere on the board
VSYS_LoRa: C58.2, C59.2, D12.1 (K), R25.1, R84.2, R86.2, R105.2, TP7.1 (1_1), U11.1 (OUT), U11.19 (OUT), U11.20 (OUT), U12.10 (Vin+)
VSYS_Pre: C54.2, C55.2, C56.2, L4.2, R25.2, R80.2, R81.2, TP6.1 (1_1), U10.3 (VOS), U11.15 (IN), U11.16 (IN), U11.17 (IN)

Notes on the sheet:
I2C1 ADDR 0x44
R81 = R82 * (VOUT / 0.6 - 1) VOUT = 5.4V
LoRa Module
LoRa Pre-Regulator
POWER ON
Set RF Voltage: VOUT=0.8*(1+R84/R85) VOUT=5.14V (R84=12.1K, R85=2.23K)
SmartConfig R_{mode} = 11k FB/VSET Pin: External FB F{SW}(MHz): 1MHz Output discharge: yes Mode: Auto PFM / PWM
LoRa Power Monitor
V_z = 5.6V
LoRa LDO
Soft Start C_{ss} = T_{ss} * I_{ss} / V{ref} I_{ss} = 2.5uA V_{ref} = V_{FB} / 0.75 = 0.6 / 0.75
POWER SAFETY
Rsense

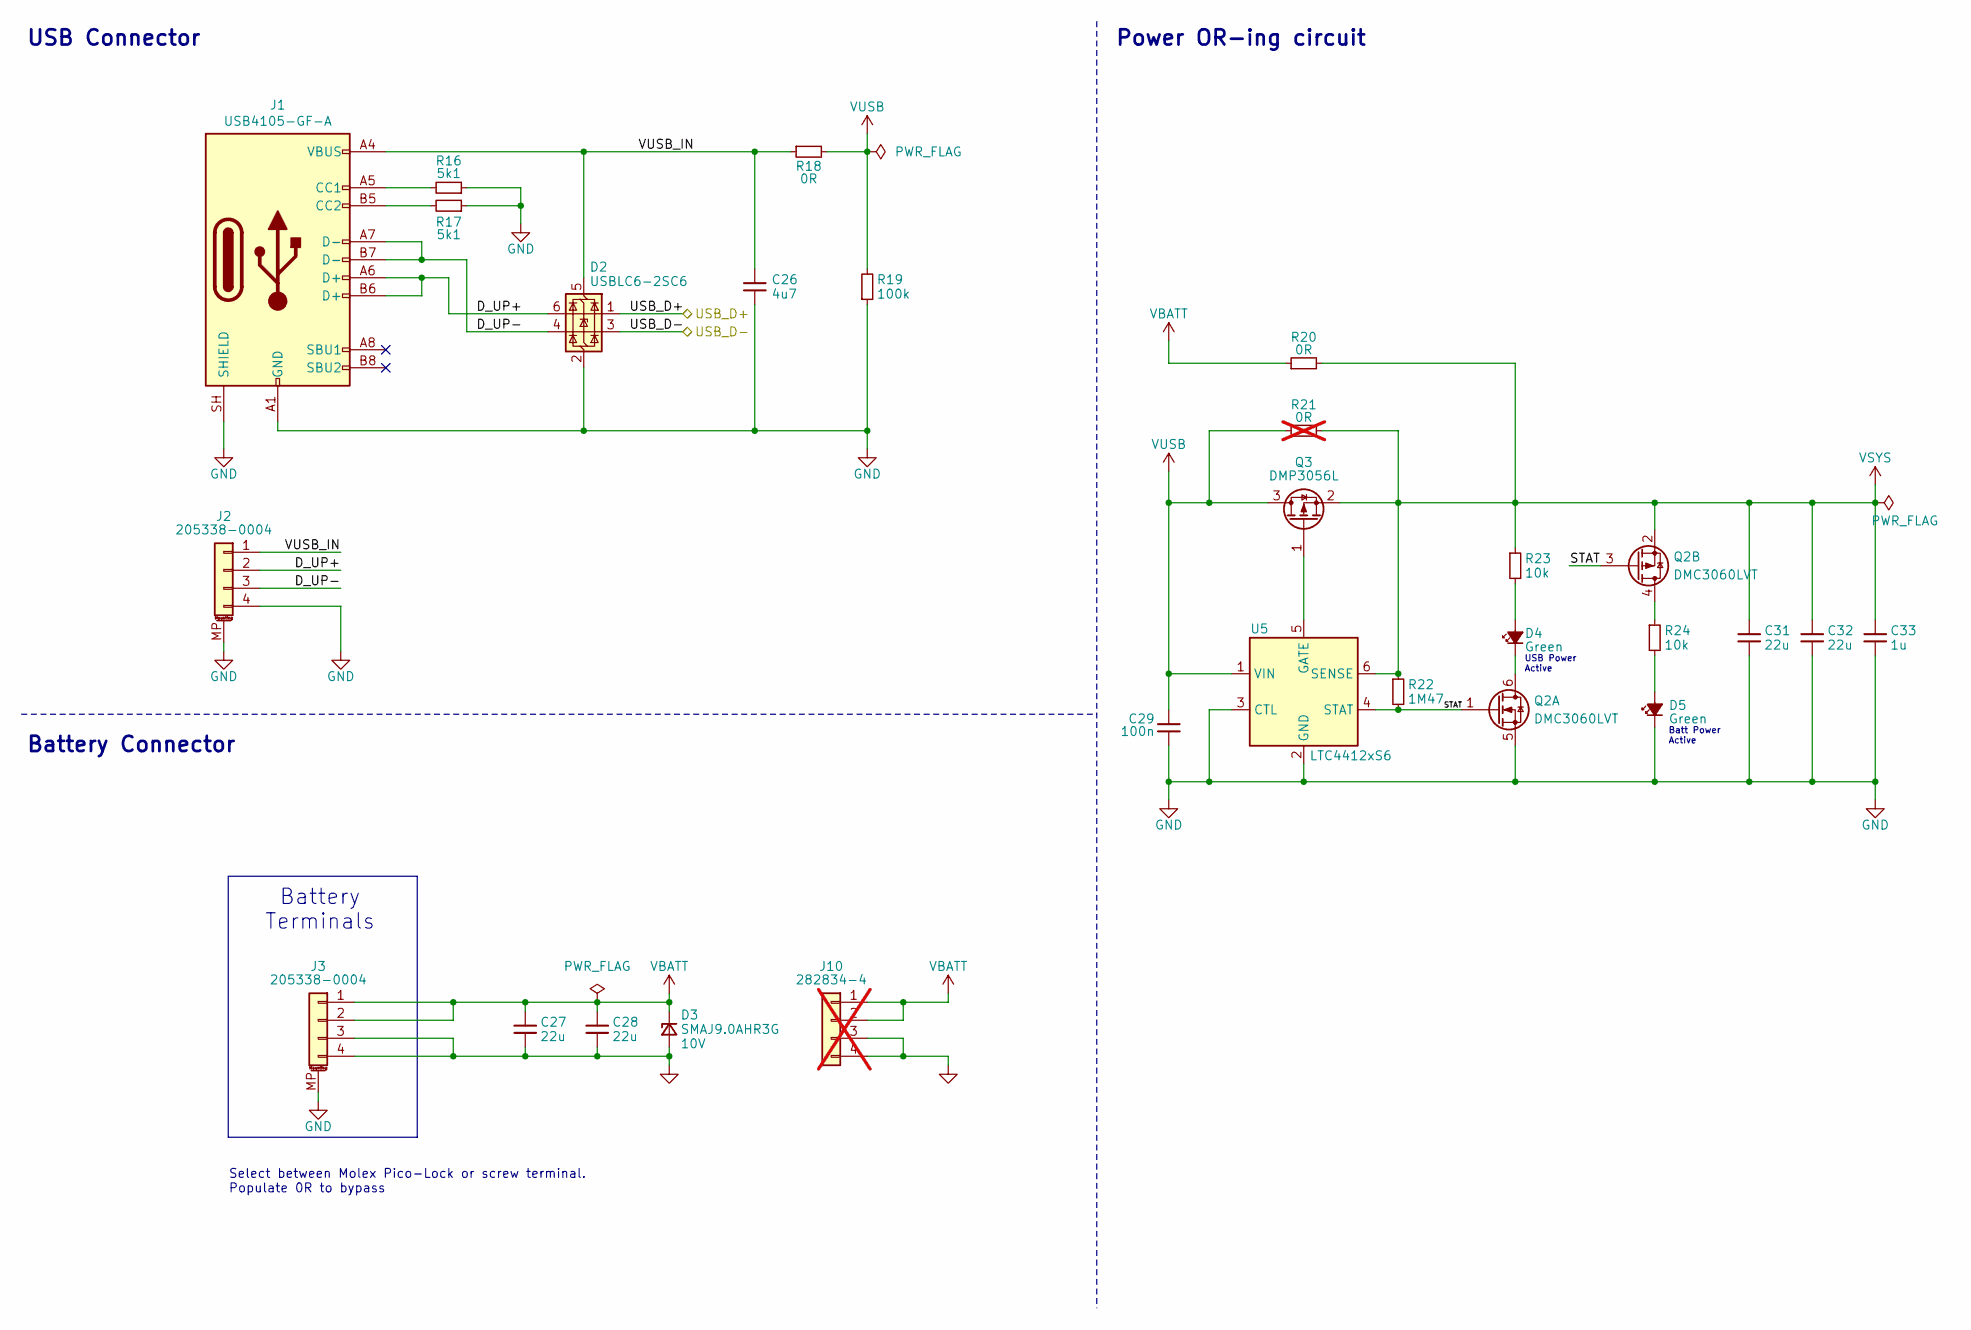
[picture p9: schematic PowerSelection.kicad_sch, Argus Mainboard]

Parts:
C26: 4u7; C_0805_2012Metric; MPN C3861036
C27, C28, C31, C32: 22u; C_1210_3225Metric; MPN C2803395
C29: 100n; C_0603_1608Metric; MPN C386084
C33: 1u; C_0603_1608Metric; MPN C2214844
D2: USBLC6-2SC6; SOT-23-6; MPN C7519
D3: SMAJ9.0AHR3G; D_SMA; Part 10V
D4, D5: LED_G_0603_LTST-C190GKT; LED_0603_1608Metric; MPN C2909774
J1: USB4105-GF-A; USB_C_Receptacle_GCT_USB4105-xx-A_16P_TopMnt_Horizontal; MPN C3020560
J2, J3: 205338-0004; Molex_Pico-Lock_205338-0004_1x04-1MP_P2.00mm_Horizontal; MPN C916325
J10: 282834-4; TE_282834-4; not fitted
Q2: DMC3060LVT; TSOT-23-6
Q3: DMP3056L; SOT-23
R16, R17: 5k1; R_0603_1608Metric; MPN C2484686
R18, R20: 0R; R_0603_1608Metric; MPN C844915
R19: 100k; R_0603_1608Metric; MPN C2479067
R21: 0R; R_0603_1608Metric; MPN C844915; not fitted
R22: 1M47; R_0603_1608Metric; MPN C237792
R23, R24: 10k; R_0603_1608Metric; MPN C237792
U5: LTC4412xS6; TSOT-23-6

Connections:
/Power Selection/D_UP+: D2.6 (I/O1), J1.A6 (D+), J1.B6 (D+), J2.2
/Power Selection/D_UP-: D2.4 (I/O2), J1.A7 (D-), J1.B7 (D-), J2.3
/Power Selection/STAT: Q2.1 (G), Q2.3 (G), R22.2, U5.4 (STAT)
/Power Selection/USB_D+: D2.1 (I/O1); also elsewhere on the board
/Power Selection/USB_D-: D2.3 (I/O2); also elsewhere on the board
/Power Selection/VUSB_IN: C26.1, D2.5 (VBUS), J1.A4 (VBUS), J1.A9 (VBUS), J1.B4 (VBUS), J1.B9 (VBUS), J2.1, R18.1
GND: C26.2, C27.2, C28.2, C29.1, C31.1, C32.1, C33.2, D2.2 (GND), D3.2 (A), D5.1 (K), J1.A1 (GND), J1.A12 (GND), J1.B1 (GND), J1.B12 (GND), J1.SH (SHIELD), J2.4, J2.MP (MountPin), J3.3, J3.4, J3.MP (MountPin), J10.3, J10.4, Q2.5 (S), R16.1, R17.1, R19.1, U5.2 (GND), U5.3 (CTL); also elsewhere on the board
unnamed: D4.2 (A), R23.2
unnamed: D4.1 (K), Q2.6 (D)
unnamed: D5.2 (A), R24.2
unnamed: J1.A5 (CC1), R16.2
unnamed: J1.B5 (CC2), R17.2
unnamed: Q2.4 (D), R24.1
unnamed: Q3.1 (G), U5.5 (GATE)
VBATT: C27.1, C28.1, D3.1 (K), J3.1, J3.2, J10.1, J10.2, R20.1; also elsewhere on the board
VSYS: C31.2, C32.2, C33.1, Q2.2 (S), Q3.2 (S), R20.2, R21.2, R22.1, R23.1, U5.6 (SENSE); also elsewhere on the board
VUSB: C29.2, Q3.3 (D), R18.2, R19.2, R21.1, U5.1 (VIN)

Notes on the sheet:
Batt Power Active
Power OR-ing circuit
Battery Connector
Select between Molex Pico-Lock or screw terminal. Populate 0R to bypass
USB Power Active
USB Connector
Battery Terminals

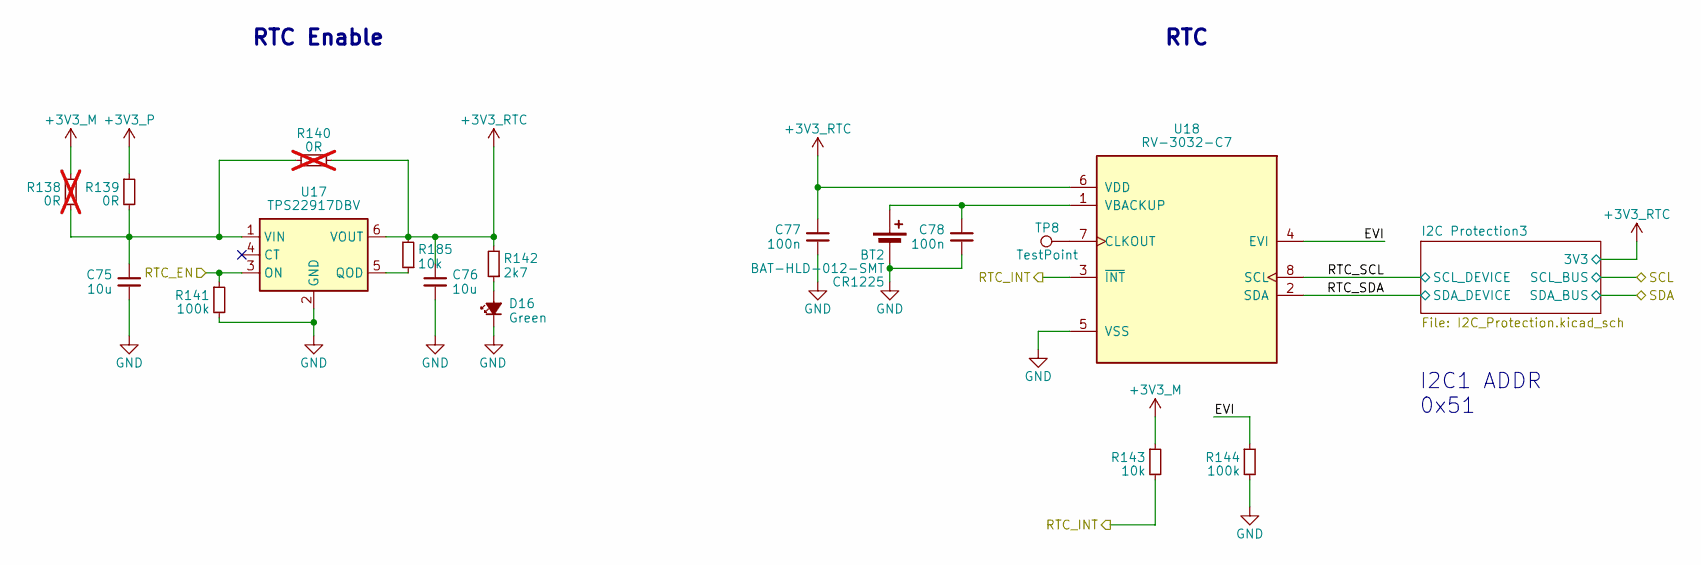
[picture p10: schematic RTC.kicad_sch, Argus Mainboard]

Parts:
BT2: BAT-HLD-012-SMT; BatteryHolder_LINX_BAT-HLD-012-SMT; MPN C5189234
C75, C76: 10u; C_0805_2012Metric; MPN C307348
C77, C78: 100n; C_0603_1608Metric; MPN C307348
D16: LED_G_0603_LTST-C190GKT; LED_0603_1608Metric; MPN C2909774
R138, R140: 0R; R_0603_1608Metric; not fitted
R139: 0R; R_0603_1608Metric
R141, R144: 100k; R_0603_1608Metric
R142: 2k7; R_0603_1608Metric; MPN C237112
R143: 10k; R_0603_1608Metric
R185: 10k; R_0603_1608Metric; MPN C237112
TP8: TestPoint; TestPoint_Pad_D1.5mm
U17: TPS22917DBV; SOT-23-6
U18: RV-3032-C7; IC_RV-3032-C7-32.768KHZ-2.5PPM-TA-QC

Connections:
+3V3_M: R138.1, R143.1; also elsewhere on the board
+3V3_P: R139.1; also elsewhere on the board
+3V3_RTC: C76.1, C77.1, R140.1, R142.2, R185.2, U17.6 (VOUT), U18.6 (VDD); also elsewhere on the board
/MCU_IO/RTC_EN: R141.1, U17.3 (ON); also elsewhere on the board
/MCU_IO/RTC_INT: R143.2, U18.3 (~INT); also elsewhere on the board
/RTC/EVI: R144.1, U18.4 (EVI)
/RTC/RTC_SCL: U18.8 (SCL); also elsewhere on the board
/RTC/RTC_SDA: U18.2 (SDA); also elsewhere on the board
GND: BT2.2 (-), C75.2, C76.2, C77.2, C78.2, D16.1 (K), R141.2, R144.2, U17.2 (GND), U18.5 (VSS); also elsewhere on the board
unnamed: BT2.1 (+), C78.1, U18.1 (VBACKUP)
unnamed: D16.2 (A), R142.1
unnamed: R185.1, U17.5 (QOD)
unnamed: C75.1, R138.2, R139.2, R140.2, U17.1 (VIN)
unnamed: TP8.1 (1_1), U18.7 (CLKOUT)

Notes on the sheet:
RTC Enable
I2C1 ADDR 0x51
RTC

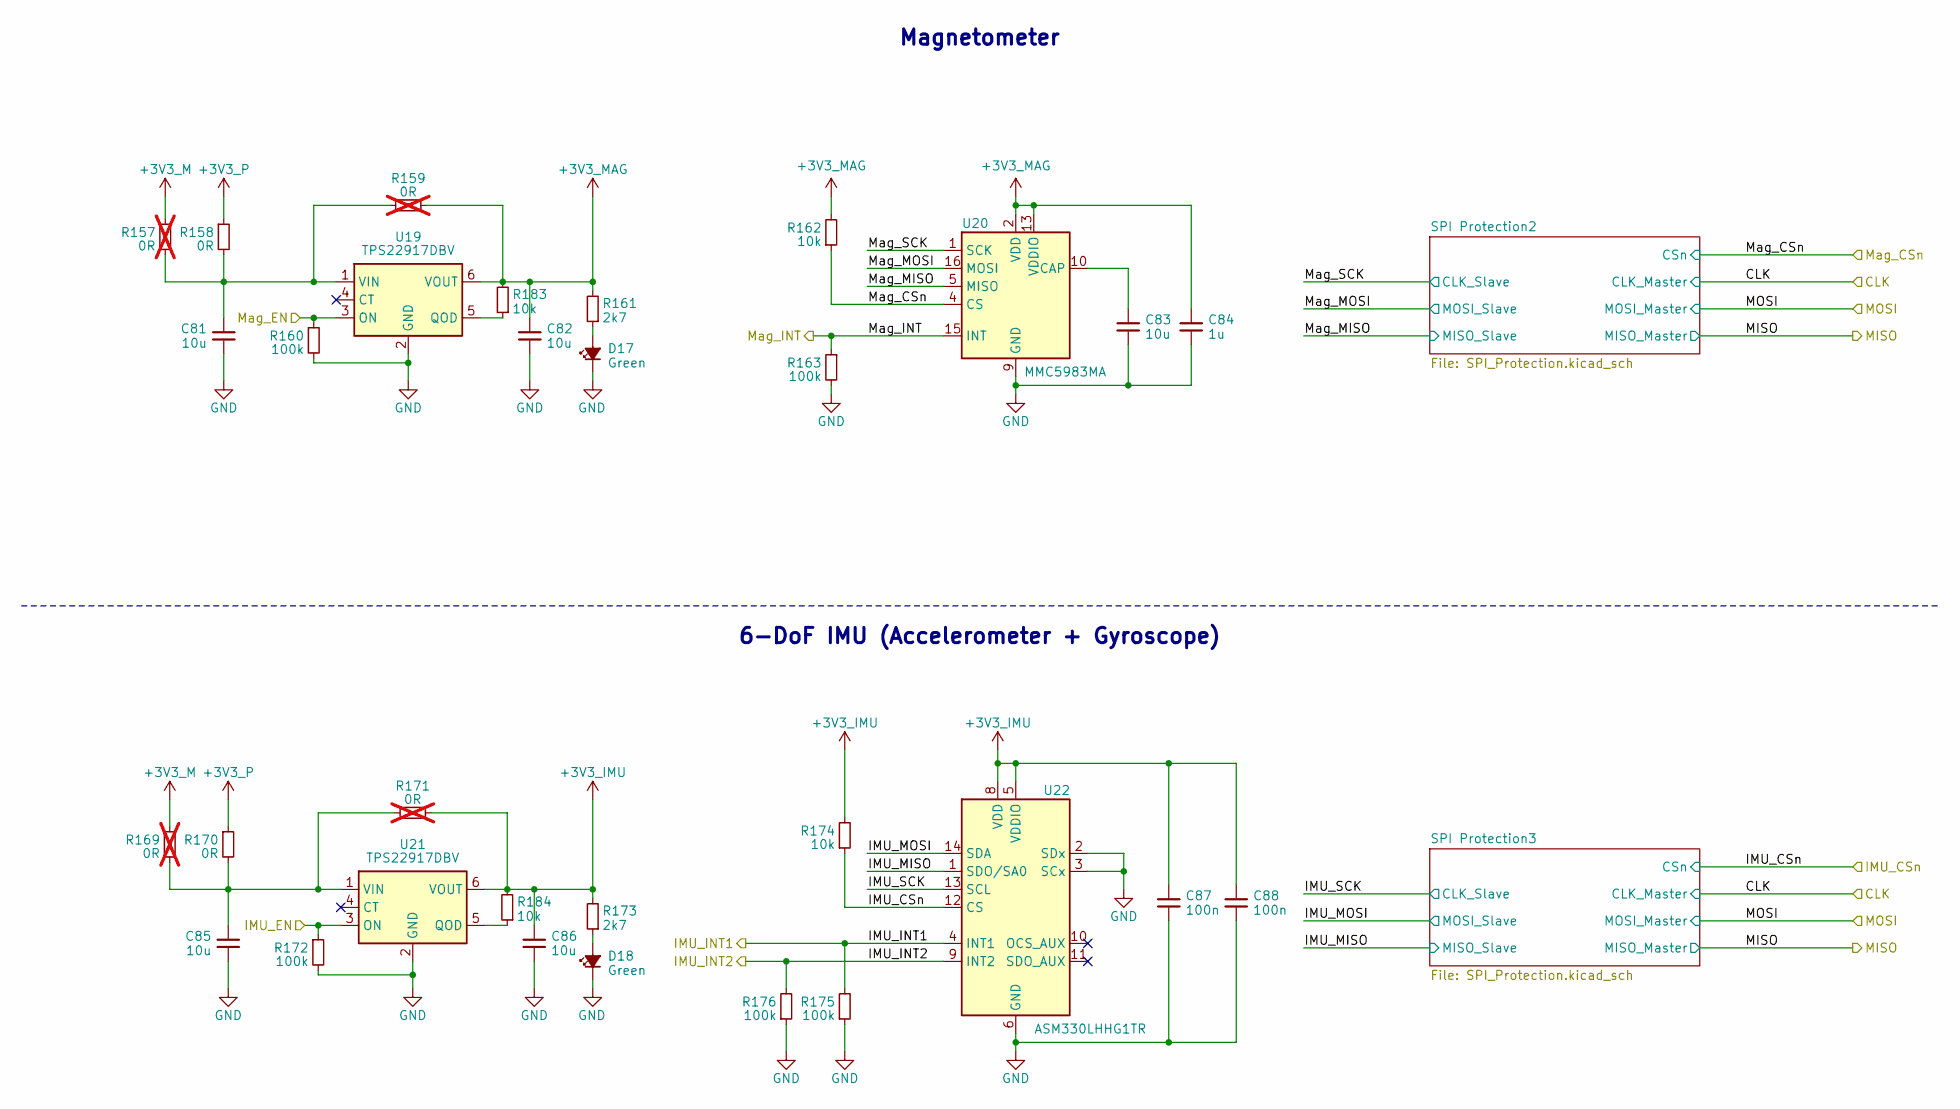
[picture p11: schematic IMU.kicad_sch, Argus Mainboard]

Parts:
C81, C82, C83, C85, C86: 10u; C_0805_2012Metric; MPN C307348
C84: 1u; C_0603_1608Metric; MPN C307348
C87, C88: 100n; C_0603_1608Metric; MPN C307348
D17, D18: LED_G_0603_LTST-C190GKT; LED_0603_1608Metric; MPN C2909774
R157, R159, R169, R171: 0R; R_0603_1608Metric; not fitted
R158, R170: 0R; R_0603_1608Metric
R160, R172: 100k; R_0603_1608Metric
R161, R173: 2k7; R_0603_1608Metric; MPN C237112
R162, R174: 10k; R_0603_1608Metric; MPN C2479067
R163, R175, R176: 100k; R_0603_1608Metric; MPN C2479067
R183, R184: 10k; R_0603_1608Metric; MPN C237112
U19, U21: TPS22917DBV; SOT-23-6
U20: MMC5983MA; LGA-16_3x3mm_P0.5mm
U22: ASM330LHHG1TR; LGA-14_3x2.5mm_P0.5mm_LayoutBorder3x4y

Connections:
+3V3_IMU: C86.1, C87.1, C88.1, R171.1, R173.2, R174.2, R184.2, U21.6 (VOUT), U22.5 (VDDIO), U22.8 (VDD)
+3V3_M: R157.1, R169.1; also elsewhere on the board
+3V3_MAG: C82.1, C84.1, R159.1, R161.2, R162.2, R183.2, U19.6 (VOUT), U20.2 (VDD), U20.13 (VDDIO)
+3V3_P: R158.1, R170.1; also elsewhere on the board
/IMU/IMU_CSn: R174.1, U22.12 (CS); also elsewhere on the board
/IMU/IMU_INT1: R175.2, U22.4 (INT1); also elsewhere on the board
/IMU/IMU_INT2: R176.2, U22.9 (INT2); also elsewhere on the board
/IMU/IMU_MISO: U22.1 (SDO/SA0); also elsewhere on the board
/IMU/IMU_MOSI: U22.14 (SDA); also elsewhere on the board
/IMU/IMU_SCK: U22.13 (SCL); also elsewhere on the board
/IMU/Mag_CSn: R162.1, U20.4 (CS); also elsewhere on the board
/IMU/Mag_INT: R163.1, U20.15 (INT); also elsewhere on the board
/IMU/Mag_MISO: U20.5 (MISO); also elsewhere on the board
/IMU/Mag_MOSI: U20.16 (MOSI); also elsewhere on the board
/IMU/Mag_SCK: U20.1 (SCK); also elsewhere on the board
/MCU_IO/IMU_EN: R172.1, U21.3 (ON); also elsewhere on the board
/MCU_IO/Mag_EN: R160.1, U19.3 (ON); also elsewhere on the board
GND: C81.2, C82.2, C83.2, C84.2, C85.2, C86.2, C87.2, C88.2, D17.1 (K), D18.1 (K), R160.2, R163.2, R172.2, R175.1, R176.1, U19.2 (GND), U20.9 (GND), U20.11 (GND), U21.2 (GND), U22.2 (SDx), U22.3 (SCx), U22.6 (GND), U22.7 (GND); also elsewhere on the board
unnamed: D17.2 (A), R161.1
unnamed: D18.2 (A), R173.1
unnamed: R183.1, U19.5 (QOD)
unnamed: C81.1, R157.2, R158.2, R159.2, U19.1 (VIN)
unnamed: C83.1, U20.10 (CAP)
unnamed: R184.1, U21.5 (QOD)
unnamed: C85.1, R169.2, R170.2, R171.2, U21.1 (VIN)

Notes on the sheet:
Magnetometer
6-DoF IMU (Accelerometer + Gyroscope)

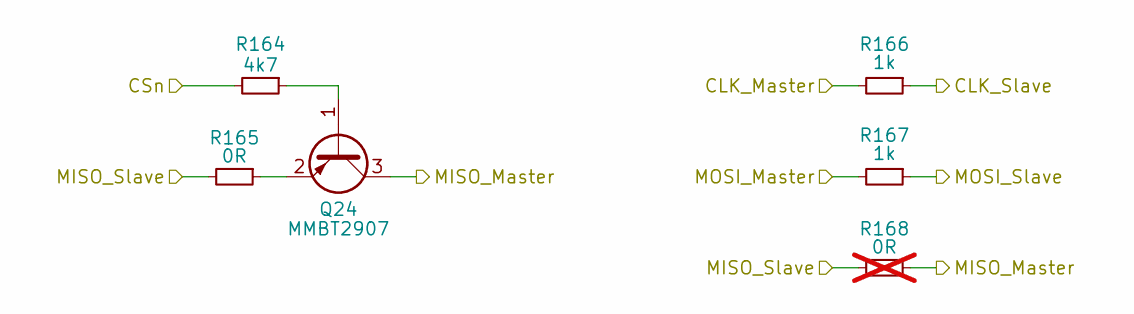
[picture p12: schematic SPI_Protection.kicad_sch, Argus Mainboard]

Parts:
Q24: MMBT2907; SOT-23; MPN C5354954
R164: 4k7; R_0603_1608Metric; MPN C844931
R165: 0R; R_0603_1608Metric; MPN C844915
R166, R167: 1k; R_0603_1608Metric; MPN C2484712
R168: 0R; R_0603_1608Metric; not fitted

Connections:
/IMU/CLK: R166.2; also elsewhere on the board
/IMU/MISO: Q24.3 (C), R168.1; also elsewhere on the board
/IMU/MOSI: R167.2; also elsewhere on the board
/IMU/Mag_CSn: R164.2; also elsewhere on the board
/IMU/Mag_MISO: R165.2, R168.2; also elsewhere on the board
/IMU/Mag_MOSI: R167.1; also elsewhere on the board
/IMU/Mag_SCK: R166.1; also elsewhere on the board
unnamed: Q24.1 (B), R164.1
unnamed: Q24.2 (E), R165.1

Parts of its further copies:
Q18, Q19, Q25: MMBT2907; SOT-23; MPN C5354954
R110, R133, R177: 4k7; R_0603_1608Metric; MPN C844931
R111, R134, R178: 0R; R_0603_1608Metric; MPN C844915
R112, R113, R135, R136, R179, R180: 1k; R_0603_1608Metric; MPN C2484712
R114, R137, R181: 0R; R_0603_1608Metric; not fitted

Connections of its further copies:
/IMU/CLK: R112.2, R135.2, R179.2; also elsewhere on the board
/IMU/IMU_CSn: R177.2; also elsewhere on the board
/IMU/IMU_MISO: R178.2, R181.2; also elsewhere on the board
/IMU/IMU_MOSI: R180.1; also elsewhere on the board
/IMU/IMU_SCK: R179.1; also elsewhere on the board
/IMU/MISO: Q18.3 (C), Q19.3 (C), Q25.3 (C), R114.1, R137.1, R181.1; also elsewhere on the board
/IMU/MOSI: R113.2, R136.2, R180.2; also elsewhere on the board
/LoRa/LoRa_CSn: R110.2; also elsewhere on the board
/LoRa/LoRa_MISO: R111.2, R114.2; also elsewhere on the board
/LoRa/LoRa_MOSI: R113.1; also elsewhere on the board
/LoRa/LoRa_SCK: R112.1; also elsewhere on the board
/MCU_IO/SD_CSn: R133.2; also elsewhere on the board
/SD/SD_CLK: R135.1; also elsewhere on the board
/SD/SD_MISO: R134.2, R137.2; also elsewhere on the board
/SD/SD_MOSI: R136.1; also elsewhere on the board
unnamed: Q18.1 (B), R110.1
unnamed: Q18.2 (E), R111.1
unnamed: Q19.1 (B), R133.1
unnamed: Q19.2 (E), R134.1
unnamed: Q25.1 (B), R177.1
unnamed: Q25.2 (E), R178.1

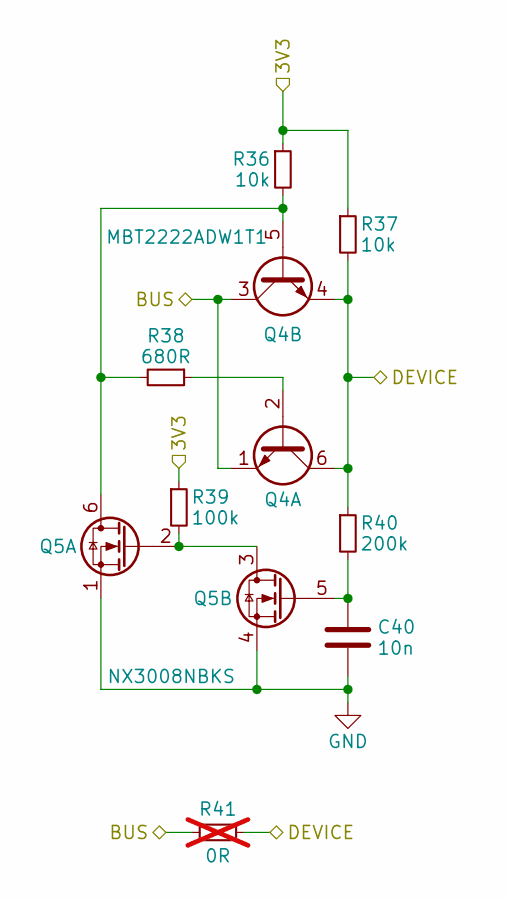
[picture p13: schematic WireProtection.kicad_sch, Argus Mainboard]

Parts:
C40: 10n; C_0603_1608Metric; MPN C161232
Q4: MBT2222ADW1T1; SOT-363_SC-70-6; Manufacturer_Part_Number MBT2222ADW1T1G
Q5: NX3008NBKS; SOT-363_SC-70-6; MPN C3280240
R36, R37: 10k; R_0603_1608Metric; MPN C2479067
R38: 680R; R_0603_1608Metric; MPN C844802
R39: 100k; R_0603_1608Metric; MPN C237792
R40: 200k; R_0603_1608Metric; MPN C118142
R41: 0R; R_0603_1608Metric; not fitted

Connections:
/MCU_IO/I2C0_SCL: Q4.1 (E1), Q4.3 (C2), R41.2; also elsewhere on the board
/Main Power/I2C Protection/SCL_DEVICE: Q4.4 (E2), Q4.6 (C1), R37.2, R40.1, R41.1; also elsewhere on the board
GND: C40.2, Q5.1 (S), Q5.4 (S); also elsewhere on the board
unnamed: Q4.2 (B1), R38.1
unnamed: Q4.5 (B2), Q5.6 (D), R36.2, R38.2
unnamed: Q5.2 (G), Q5.3 (D), R39.2
unnamed: C40.1, Q5.5 (G), R40.2
VDD_M: R36.1, R37.1, R39.1; also elsewhere on the board

Parts of its further copies:
C41, C48, C49, C61, C62, C79, C80: 10n; C_0603_1608Metric; MPN C161232
Q6, Q8, Q10, Q14, Q16, Q20, Q22: MBT2222ADW1T1; SOT-363_SC-70-6; Manufacturer_Part_Number MBT2222ADW1T1G
Q7, Q9, Q11, Q15, Q17, Q21, Q23: NX3008NBKS; SOT-363_SC-70-6; MPN C3280240
R42, R43, R58, R59, R64, R65, R93, R94, R99, R100, R145, R146, R151, R152: 10k; R_0603_1608Metric; MPN C2479067
R44, R60, R66, R95, R101, R147, R153: 680R; R_0603_1608Metric; MPN C844802
R45, R61, R67, R96, R102, R148, R154: 100k; R_0603_1608Metric; MPN C237792
R46, R62, R68, R97, R103, R149, R155: 200k; R_0603_1608Metric; MPN C118142
R47, R63, R69, R98, R104, R150, R156: 0R; R_0603_1608Metric; not fitted

Connections of its further copies:
+3V3_RTC: R145.1, R146.1, R148.1, R151.1, R152.1, R154.1; also elsewhere on the board
/LoRa/I2C Protection2/SCL_DEVICE: Q14.4 (E2), Q14.6 (C1), R94.2, R97.1, R98.1; also elsewhere on the board
/LoRa/I2C Protection2/SDA_DEVICE: Q16.4 (E2), Q16.6 (C1), R100.2, R103.1, R104.1; also elsewhere on the board
/MCU_IO/I2C0_SCL: Q8.1 (E1), Q8.3 (C2), Q14.1 (E1), Q14.3 (C2), Q20.1 (E1), Q20.3 (C2), R63.2, R98.2, R150.2; also elsewhere on the board
/MCU_IO/I2C0_SDA: Q6.1 (E1), Q6.3 (C2), Q10.1 (E1), Q10.3 (C2), Q16.1 (E1), Q16.3 (C2), Q22.1 (E1), Q22.3 (C2), R47.2, R69.2, R104.2, R156.2; also elsewhere on the board
/Main Power/I2C Protection1/SCL_DEVICE: Q8.4 (E2), Q8.6 (C1), R59.2, R62.1, R63.1; also elsewhere on the board
/Main Power/I2C Protection1/SDA_DEVICE: Q10.4 (E2), Q10.6 (C1), R65.2, R68.1, R69.1; also elsewhere on the board
/Main Power/I2C Protection/SDA_DEVICE: Q6.4 (E2), Q6.6 (C1), R43.2, R46.1, R47.1; also elsewhere on the board
/RTC/RTC_SCL: Q20.4 (E2), Q20.6 (C1), R146.2, R149.1, R150.1; also elsewhere on the board
/RTC/RTC_SDA: Q22.4 (E2), Q22.6 (C1), R152.2, R155.1, R156.1; also elsewhere on the board
GND: C41.2, C48.2, C49.2, C61.2, C62.2, C79.2, C80.2, Q7.1 (S), Q7.4 (S), Q9.1 (S), Q9.4 (S), Q11.1 (S), Q11.4 (S), Q15.1 (S), Q15.4 (S), Q17.1 (S), Q17.4 (S), Q21.1 (S), Q21.4 (S), Q23.1 (S), Q23.4 (S); also elsewhere on the board
unnamed: Q6.2 (B1), R44.1
unnamed: Q6.5 (B2), Q7.6 (D), R42.2, R44.2
unnamed: Q7.2 (G), Q7.3 (D), R45.2
unnamed: C41.1, Q7.5 (G), R46.2
unnamed: Q8.2 (B1), R60.1
unnamed: Q8.5 (B2), Q9.6 (D), R58.2, R60.2
unnamed: Q9.2 (G), Q9.3 (D), R61.2
unnamed: C48.1, Q9.5 (G), R62.2
unnamed: Q10.2 (B1), R66.1
unnamed: Q10.5 (B2), Q11.6 (D), R64.2, R66.2
unnamed: Q11.2 (G), Q11.3 (D), R67.2
unnamed: C49.1, Q11.5 (G), R68.2
unnamed: Q14.2 (B1), R95.1
unnamed: Q14.5 (B2), Q15.6 (D), R93.2, R95.2
unnamed: Q15.2 (G), Q15.3 (D), R96.2
unnamed: C61.1, Q15.5 (G), R97.2
unnamed: Q16.2 (B1), R101.1
unnamed: Q16.5 (B2), Q17.6 (D), R99.2, R101.2
unnamed: Q17.2 (G), Q17.3 (D), R102.2
unnamed: C62.1, Q17.5 (G), R103.2
unnamed: Q20.2 (B1), R147.1
unnamed: Q20.5 (B2), Q21.6 (D), R145.2, R147.2
unnamed: Q21.2 (G), Q21.3 (D), R148.2
unnamed: C79.1, Q21.5 (G), R149.2
unnamed: Q22.2 (B1), R153.1
unnamed: Q22.5 (B2), Q23.6 (D), R151.2, R153.2
unnamed: Q23.2 (G), Q23.3 (D), R154.2
unnamed: C80.1, Q23.5 (G), R155.2
VDD_L: R93.1, R94.1, R96.1, R99.1, R100.1, R102.1; also elsewhere on the board
VDD_M: R42.1, R43.1, R45.1; also elsewhere on the board
VDD_P: R58.1, R59.1, R61.1, R64.1, R65.1, R67.1; also elsewhere on the board

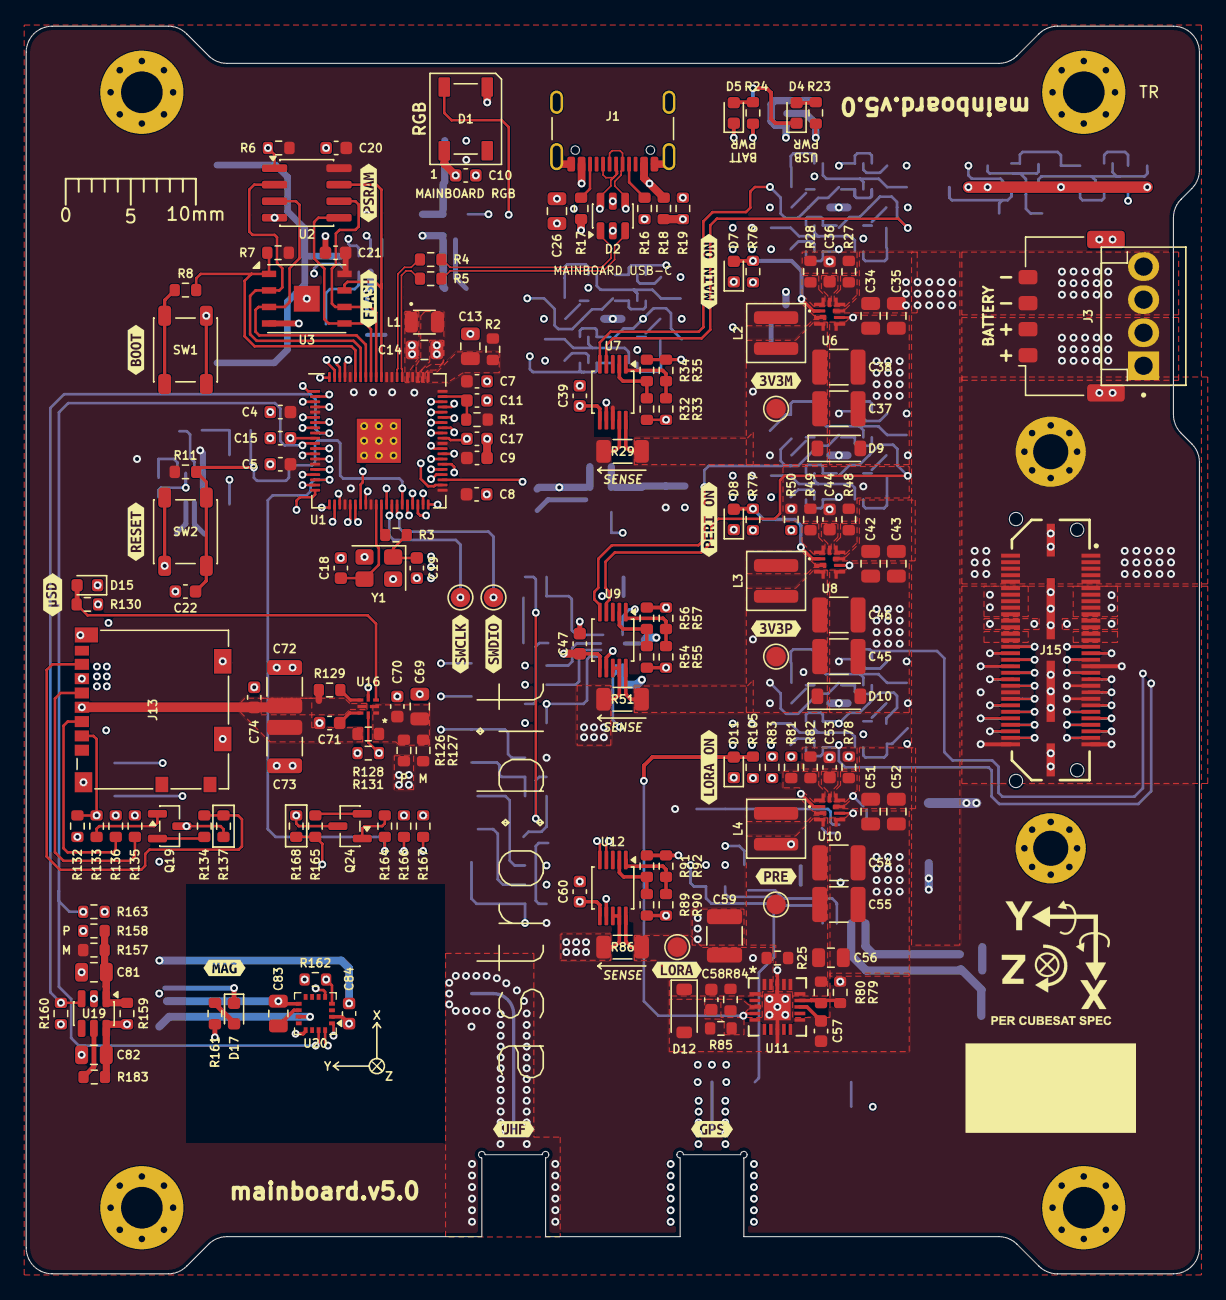
[picture p14: board Avionics-MainBoard.kicad_pcb from above]

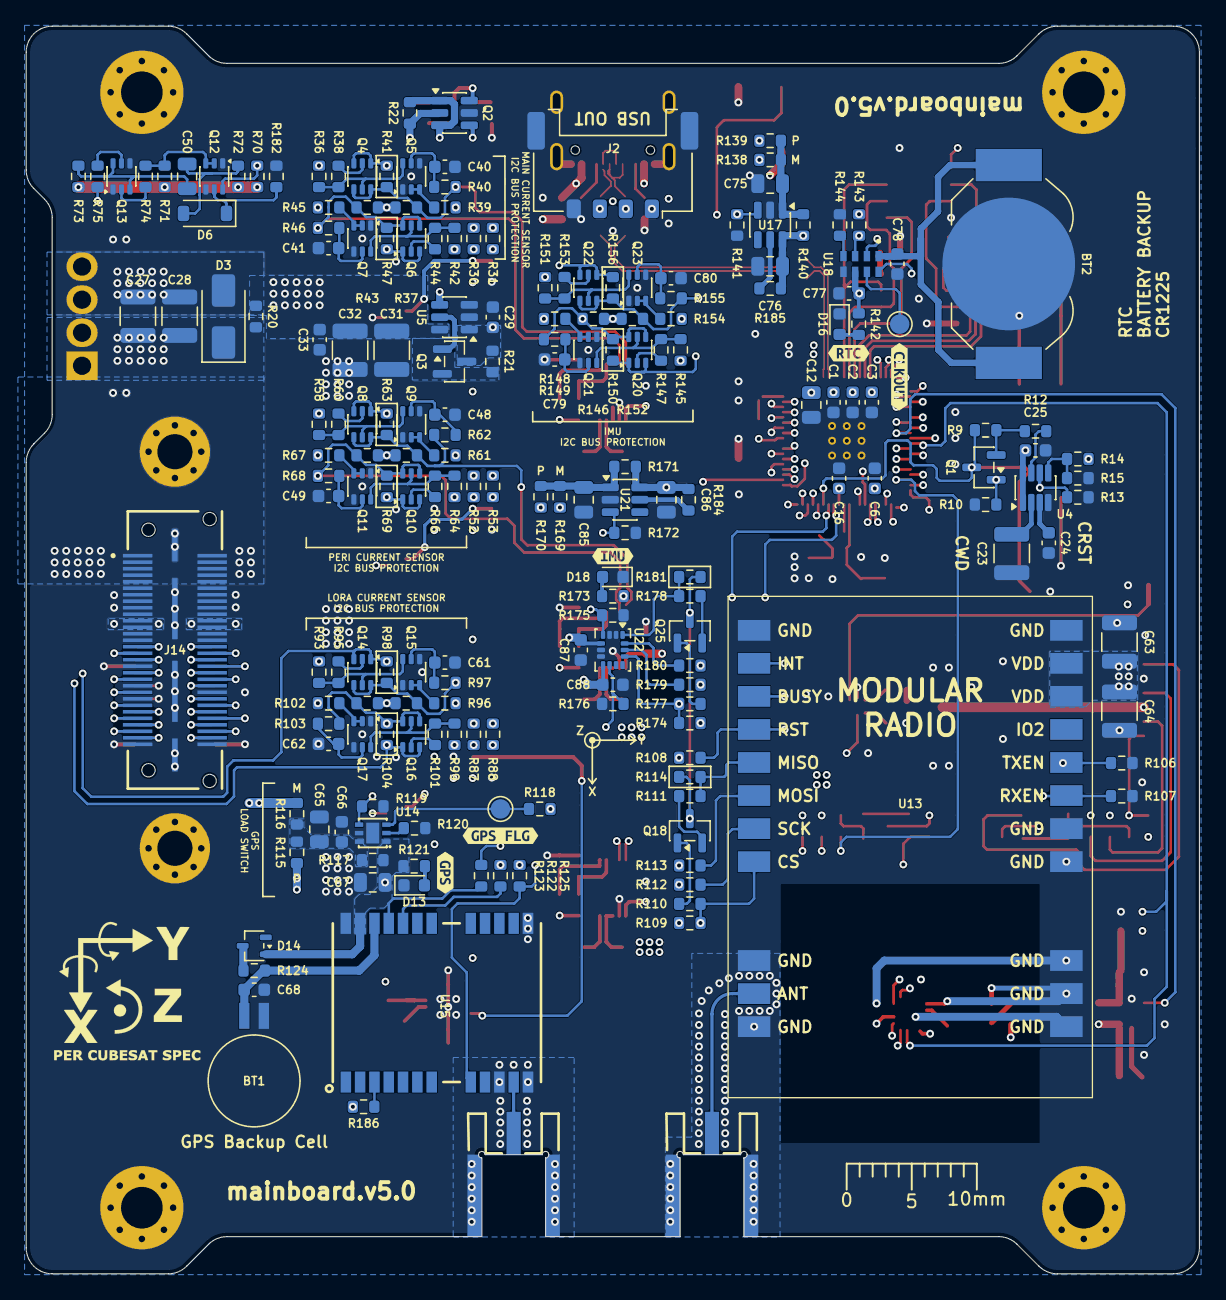
[picture p15: board Avionics-MainBoard.kicad_pcb from below]

Board: 4 copper layers, 90.2 x 95.9 mm, 391 parts (202 on the bottom side), 230 nets.

Other parts of the board:
kibuzzard-6A94A6EB: G***; kibuzzard-6A94A6EB
kibuzzard-6A94A6F2: G***; kibuzzard-6A94A6F2
kibuzzard-6A94A9F0: G***; kibuzzard-6A94A9F0
kibuzzard-6A94A74C: G***; kibuzzard-6A94A74C
kibuzzard-6A94A84D: G***; kibuzzard-6A94A84D
kibuzzard-6A94A845: G***; kibuzzard-6A94A845
kibuzzard-6A94A973: G***; kibuzzard-6A94A973
kibuzzard-6A94AA08: G***; kibuzzard-6A94AA08
kibuzzard-6A94AA93: G***; kibuzzard-6A94AA93
kibuzzard-6A94AAA8: G***; kibuzzard-6A94AAA8
kibuzzard-6A94AF59: G***; kibuzzard-6A94AF59
kibuzzard-6A94B7E3: G***; kibuzzard-6A94B7E3
kibuzzard-6A94B390: G***; kibuzzard-6A94B390
kibuzzard-6A94B568: G***; kibuzzard-6A94B568
kibuzzard-6A94B807: G***; kibuzzard-6A94B807
kibuzzard-67C0A908: G***; kibuzzard-67C0A908
kibuzzard-67C0B8D2: G***; kibuzzard-67C0B8D2
kibuzzard-67C0B8E2: G***; kibuzzard-67C0B8E2
kibuzzard-67C0B43D: G***; kibuzzard-67C0B43D
kibuzzard-67C0B44F: G***; kibuzzard-67C0B44F
kibuzzard-67C0B466: G***; kibuzzard-67C0B466
kibuzzard-67C0B482: G***; kibuzzard-67C0B482
