cmu-argus-2/Avionics-Mainboard/(commit log)

2024-10-06 Initial commit of v1
    [104031-0811.step, 1042.step, 1048.step, 1715747.step, 1985807.step, 2005280100.stp, 2005280120.stp, 2005280150.stp]
2024-10-10 v1 done
    [Avionics-MainBoard.kicad_pcb, Avionics-MainBoard.kicad_sch, Battery.kicad_sch, Connectors.kicad_sch, GPS_Power.kicad_sch, IMU.kicad_sch, LoRa_Power.kicad_sch, MCU_IO.kicad_sch]
2024-10-10 Updated i2c device addresses and mcu caps
    [Avionics-MainBoard.kicad_pcb, Avionics-MainBoard.kicad_sch, Connectors.kicad_sch, GPS_Power.kicad_sch, LoRa_Power.kicad_sch, MCU_IO.kicad_sch, MainPower.kicad_sch, RS485.kicad_sch]
2024-10-10 Added extra connector
    [Avionics-MainBoard.kicad_pcb, Avionics-MainBoard.kicad_sch, Connectors.kicad_sch, LoRa_Power.kicad_sch, MCU_IO.kicad_sch]
2024-10-10 Silkscreen hiding
    [Avionics-MainBoard.kicad_pcb, LoRa_Power.kicad_sch]
2024-10-22 Updated connector locations
    [Avionics-MainBoard.kicad_pcb, Connectors.kicad_sch]
2024-10-22 Fixed schematic bugs and corresponding layout modifications
    [Avionics-MainBoard.kicad_pcb, Avionics-MainBoard.kicad_sch, Connectors.kicad_sch, GPS_Power.kicad_sch, LoRa_Power.kicad_sch, MCU_IO.kicad_sch, RTC.kicad_sch]
2024-10-23 Updated connector locations and types
    [Avionics-MainBoard.kicad_pcb, Battery.kicad_sch, Connectors.kicad_sch, MCU_IO.kicad_sch]
2024-10-24 Added silkscreen
    [Avionics-MainBoard.kicad_pcb]
2024-10-25 Minor fixes, export BOM
    [Avionics-MainBoard.kicad_pcb, LoRa_Power.kicad_sch]
2024-10-25 Added footprints and reexported STEP
    [Avionics-MainBoard.kicad_pcb]
2024-11-16 Added better protection to SD card, Jetson IO, and added address breakouts to power monitors
    [Avionics-MainBoard.csv, Avionics-MainBoard.kicad_pcb, Avionics-MainBoard.kicad_sch, Battery.kicad_sch, Connectors.kicad_sch, GPS_Power.kicad_sch, LoRa_Power.kicad_sch, MCU_IO.kicad_sch]
2024-11-16 Added extra decoupling caps to LoRa
    [Avionics-MainBoard.kicad_pcb, LoRa_Power.kicad_sch]
2024-11-19 Updated version to v2.1
    [Avionics-MainBoard.kicad_pcb, Avionics-MainBoard.kicad_sch, Battery.kicad_sch, Connectors.kicad_sch, GPS_Power.kicad_sch, I2C_Protection.kicad_sch, IMU.kicad_sch, Interfaces.kicad_sch]
2024-11-19 Moved csv bom
    [Avionics-MainBoard.csv]
2024-11-19 Removed submodule KiCad-Libraries
2024-11-19 Re-add Kicad-libraries
2025-01-08 v3 partial schematic updates
    [Avionics-MainBoard.kicad_sch, Battery.kicad_sch, Connectors.kicad_sch, GPS.kicad_sch, I2C_Protection.kicad_sch, IMU.kicad_sch, LoRa.kicad_sch, MCU_IO.kicad_sch]
2025-02-26 v3 Layout complete
    [Avionics-MainBoard.kicad_sch, Battery.kicad_sch, Connectors.kicad_sch, GPS.kicad_sch, GPS_Power.kicad_sch, I2C_Protection.kicad_sch, IMU.kicad_sch, LoRa.kicad_sch]
2025-02-28 Addressed design issues
    [Connectors.kicad_sch, GPS.kicad_sch, IMU.kicad_sch, LoRa.kicad_sch, MCU_IO.kicad_sch, MainPower.kicad_sch, Payload.kicad_sch, RTC.kicad_sch]
2025-06-16 v4.0 Updates
    [Avionics-MainBoard.kicad_pcb, Avionics-MainBoard.kicad_sch, Battery.kicad_sch, Connectors.kicad_sch, GPS.kicad_sch, I2C_Protection.kicad_sch, IMU.kicad_sch, LoRa.kicad_sch]
2025-06-17 DFM updates
    [Avionics-MainBoard.kicad_pcb, Avionics-MainBoard.step, Battery.kicad_sch, Connectors.kicad_sch, GPS.kicad_sch, IMU.kicad_sch, LoRa.kicad_sch, MCU_IO.kicad_sch]
2025-06-17 Minor schematic fixes
    [LoRa.kicad_sch, MainPower.kicad_sch]
2025-06-18 Fixed Jetson FPC pinout
    [Avionics-MainBoard.kicad_pcb, Avionics-MainBoard.kicad_sch, Avionics-MainBoard.step, Connectors.kicad_sch, IMU.kicad_sch, LoRa.kicad_sch, MCU_IO.kicad_sch, MainPower.kicad_sch]
2025-10-24 Update KiCad libraries
2025-10-24 updated watchdog
    [Avionics-MainBoard.kicad_pcb, MCU_IO.kicad_sch]
2025-10-26 Updated WDT
    [Avionics-MainBoard.kicad_pcb, MCU_IO.kicad_sch]
2025-10-27 Updated silkscreen
    [Avionics-MainBoard.kicad_pcb]
2026-01-07 v4.2 Updates
    [Avionics-MainBoard.kicad_pcb, Avionics-MainBoard.kicad_sch, Battery.kicad_sch, Connectors.kicad_sch, GPS.kicad_sch, I2C_Protection.kicad_sch, IMU.kicad_sch, LoRa.kicad_sch]
2026-01-21 kicad pull
2026-02-09 Updated BOM CSV
    [Avionics-MainBoard.csv]
2026-08-31 v5.0 Updates
    [Avionics-MainBoard.kicad_pcb, Avionics-MainBoard.kicad_sch, Battery.kicad_sch, Connectors.kicad_sch, GPS.kicad_sch, I2C_Protection.kicad_sch, IMU.kicad_sch, LoRa.kicad_sch]
2026-09-04 Final v5.0 Release
    [Avionics-MainBoard-CuBottom.gbr, Avionics-MainBoard-CuIn1.gbr, Avionics-MainBoard-CuIn2.gbr, Avionics-MainBoard-CuTop.gbr, Avionics-MainBoard-EdgeCuts.gbr, Avionics-MainBoard-MaskBottom.gbr, Avionics-MainBoard-MaskTop.gbr, Avionics-MainBoard-NPTH.drl]
