cmu-argus-2/Avionics-Mainboard/(notices)

Notices in the files:
parts and their libraries:
License: Apache-2.0
